KLFAMO/current3Av2/README.md

# current3Av2
Current driver for compensating coils
