KLFAMO/current3Av2/kicad/current3Av2_bom.ods

Source: | D:\Projekty\FAMO\current3Av2\current3Av2.sch
Date: | 03.01.2023 12:33:08
Tool: | Eeschema (5.1.12)-1
Generator: | C:\Program Files\KiCad\bin\scripting\plugins/bom_csv_grouped_by_value.py
Component Count: | 218
Item | Qty | Reference(s) | Value | Footprint | Datasheet | Comm | Vendor
1 | 30 | C5, C8, C12, C18, C21, C24, C26, C31, C32, C38, C42, C46, C51, C52, C58, C62, C65, C67, C68, C69, C72, C74, C75, C78, C83, C85, C91, C92, C93, C95 | 100n 50V X7R | Capacitors_SMD:C_0603 | ~
2 | 9 | C13, C33, C53, C73, C76, C81, C82, C86, C89 | 100p 50V C0G | Capacitors_SMD:C_0603 | ~
3 | 19 | C2, C3, C7, C10, C11, C14, C17, C22, C23, C28, C34, C36, C45, C54, C56, C63, C71, C90, C94 | 10u 25V X5R | Capacitors_SMD:C_0603 | ~ | GRM188R61E106KA73D
4 | 4 | C1, C15, C35, C55 | 1n 50V C0G | Capacitors_SMD:C_0603 | ~
5 | 2 | C57, C59 | 1u 25V X7R | Capacitors_SMD:C_0603 | ~
6 | 3 | C47, C49, C96 | 470n 25V X7R | Capacitors_SMD:C_0603 | ~
7 | 1 | C27 | 56p 50V C0G | Capacitors_SMD:C_0603 | ~
8 | 1 | C60 | 82p 50V C0G | Capacitors_SMD:C_0603 | ~
9 | 3 | C84, C87, C88 | DNP | Capacitors_SMD:C_0603 | ~
10 | 1 | C44 | 10n 100V X7R | Capacitors_SMD:C_0805 | ~
11 | 2 | C43, C50 | 2,2u 25V X7R | Capacitors_SMD:C_0805 | ~
12 | 2 | C6, C16 | 470n 100V X7R | Capacitors_SMD:C_0805 | ~
13 | 3 | C37, C39, C40 | 100n 50V C0G | Capacitors_SMD:C_1206 | ~
14 | 4 | C66, C70, C79, C80 | GRM31CR71A226KE15L | Capacitors_SMD:C_1206 | ~ | 22u 10V X7R Murata
15 | 2 | C29, C41 | GRM32ER71E226KE15K | Capacitors_SMD:C_1210 | ~ | 22u 25V X7R Murata
16 | 3 | C20, C30, C61 | GRM32ER71H106KA12L | Capacitors_SMD:C_1210 | ~ | 10u 50V X7R Murata
17 | 2 | C19, C64 | 100u 16V | Capacitors_Tantalum_SMD:CP_Tantalum_Case-D_EIA-7343-31_Reflow | ~ | tantal, case D
18 | 4 | C4, C9, C25, C48 | 2200u 16V 105°C | Capacitors_THT:CP_Radial_D14.0mm_P5.00mm | ~ | >5000h Ø13x25mm P=5mm
19 | 2 | JF1, JF2 | Amphenol 031-6575 | Connector_Coaxial:BNC_Amphenol_031-6575_Horizontal | ~ | 031-6576
20 | 1 | SD1 | DM3D-SF | Connectors_Card:Hirose_DM3D-SF | https://www.hirose.com/product/document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
21 | 2 | J6, J7 | ZL231-10PG | Connectors_IDC:IDC-Header_2x05_Pitch2.54mm_Straight | ~ |  | Connfly
22 | 4 | J1, J2, J3, J4 | MSTBA 2,5/ 2-G-5,08 1757242 | Connectors_Phoenix:PhoenixContact_MSTBA-G_02x5.08mm_Angled | ~ |  | Adam Tech, TE Connectivity, Xinya, Ninigi
23 | 1 | D28 | SMAJ16A | Diodes_SMD:D_SMA | ~
24 | 15 | D2, D3, D4, D7, D8, D11, D20, D24, D25, D26, D30, D35, D36, D37, D38 | SL54-3G | Diodes_SMD:D_SMB | ~ | Diotec SL54-3G
25 | 3 | D5, D6, D9 | BZT52C18 | Diodes_SMD:D_SOD-123 | ~
26 | 1 | PD7 | LAM 5K 150 12V, dodać: THFU4 – 3szt., wkręt do metalu – 3 szt (Φmax 3mm), podkładki płaskie i sprężyste !!! | ff_lib:Heatsink_50x50x150mm_with_fan_C | https://www.fischerelektronik.de/web_fischer/en_GB/VA/LAM3K10012/datasheet.xhtml?branch=heatsinks | dodać: THFU4 – 3szt., wkręt do metalu – 3 szt (Φmax 3mm)
27 | 1 | L8 | SRP3212-3R3M | ff_lib:L_Bourns_SRP3212 | ~ | 3,3u >2A 4x4mm
28 | 1 | L1 | 50225C Murata | ff_lib:L_CommonMode_Murata_5000 | https://www.murata-ps.com/pub/data/magnetics/kmp_5000c.pdf | or 50475C
29 | 3 | L2, L5, L7 | LQH44PH220MPRL | ff_lib:L_MURATA_LQH44 | ~ | 22u >0,5A 4x4mm
30 | 1 | M1 | po1:DS1023-2*8S21, DS1023-2*10S21, DS1023-2*16S21, DS1023-2*17S21 | ff_lib:MODULE_NUCLEO-F746ZG_mini_M | STMicroelectronics
31 | 1 | U33 | R1SE-H2 | ff_lib:SOIC-5_8-10.7x12.75_Pitch2.54 | https://recom-power.com/pdf/Econoline/R1SE_H2.pdf | ISE1205A, SBTN01M-05, AM1LS-1205S-NZ
32 | 3 | U9, U18, U27 | OPA549 dowolna wersja | ff_lib:TO-220-11_Vertical_StangeredType1_or_not | http://www.ti.com/lit/ds/symlink/opa549.pdf
33 | 1 | U29 | ADUM141D1BRWZ | Housings_SOIC:SOIC-16W_7.5x10.3mm_Pitch1.27mm | https://www.analog.com/media/en/technical-documentation/data-sheets/ADUM1410_1411_1412.pdf | ADUM141D1BRWZ-RL, ADUM241D1BRIZ
34 | 6 | U2, U3, U4, U5, U7, U8 | IRS4428SPBF | Housings_SOIC:SOIC-8_3.9x4.9mm_Pitch1.27mm | https://www.ixysic.com/home/pdfs.nsf/www/IX4426-27-28.pdf/$file/IX4426-27-28.pdf | IX4428N
35 | 1 | U11 | MAX3250CAI | Housings_SSOP:SSOP-28_5.3x10.2mm_Pitch0.65mm | https://datasheets.maximintegrated.com/en/ds/MAX3250.pdf | MAX3250EAI+
36 | 1 | U14 | DAC8555IPW | Housings_SSOP:TSSOP-16_4.4x5mm_Pitch0.65mm | http://www.ti.com/lit/gpn/dac8555
37 | 1 | L4 | 33uH 200mA | Inductors_SMD:L_0805 | ~ | Viking NL05JTC330
38 | 2 | L3, L6 | 74477710 | Inductors_SMD:L_Wuerth_HCM-7050 | ~ | 10u >2A 7x7mm
39 | 1 | U12 | ADR443BRZ | Package_SO:SOIC-8_3.9x4.9mm_P1.27mm | https://www.analog.com/media/en/technical-documentation/data-sheets/ADR440_441_443_444_445.pdf
40 | 3 | D1, D10, D19 | 2BZX84C15 | Package_TO_SOT_SMD:SOT-23 | ~
41 | 3 | U6, U15, U24 | INA293B2IDBV | Package_TO_SOT_SMD:SOT-23-5 | https://www.ti.com/lit/ds/symlink/ina293.pdf?ts=1623847588072
42 | 12 | T1, T2, T3, T4, T5, T6, T7, T8, T9, T10, T11, T12 | BSC028N06NSATMA1 ** | Package_TO_SOT_SMD:TDSON-8-1 | http://www.infineon.com/dgdl/Infineon-BSC028N06LS3-DS-v02_02-en.pdf?fileId=db3a30431ddc9372011ebafa4c607f8c
43 | 2 | U1, U10 | AP63200WU | Package_TO_SOT_SMD:TSOT-23-6 | https://www.diodes.com/assets/Datasheets/AP63200-AP63201-AP63203-AP63205.pdf | AP63201WU
44 | 1 | U13 | AP63203WU-7 | Package_TO_SOT_SMD:TSOT-23-6 | https://www.diodes.com/assets/Datasheets/AP63200-AP63201-AP63203-AP63205.pdf
45 | 6 | R3, R4, R16, R17, R28, R29 | 10k 1% | Resistors_SMD:R_0603 | ~
46 | 6 | R7, R8, R19, R20, R31, R32 | 10R | Resistors_SMD:R_0603 | ~
47 | 3 | R11, R23, R35 | 14k 1% | Resistors_SMD:R_0603 | ~
48 | 1 | R44 | 180k 1% | Resistors_SMD:R_0603 | ~
49 | 18 | R1, R2, R5, R6, R9, R10, R13, R14, R15, R18, R21, R22, R25, R26, R27, R30, R33, R51 | 1k 1% | Resistors_SMD:R_0603 | ~
50 | 2 | R38, R45 | 20k 1% | Resistors_SMD:R_0603 | ~
51 | 1 | R37 | 280k 1% | Resistors_SMD:R_0603 | ~
52 | 3 | R39, R40, R41 | 47R | Resistors_SMD:R_0805 | ~
53 | 3 | R34, R42, R43 | DNP | Resistors_SMD:R_0805 | ~
54 | 3 | R12, R24, R36 | 0R02 0,5% 1W 50ppm | Resistors_SMD:R_2512 | ~ | LVK24R020DER
55 | 1 | RN1 | CAT16-101J4LF | Resistors_SMD:R_Array_Concave_4x0603 | ~
56 | 1 | RN3 | CAT16-472J4LF | Resistors_SMD:R_Array_Concave_4x0603
57 | 1 | FAN1 | TE 1546551-3 | TerminalBlock_4UCON:TerminalBlock_4UCON_19963_03x3.5mm_Straight | ~
58 | 1 | U31 | UA78M05IDCY | TO_SOT_Packages_SMD:SOT-223-3_TabPin2
** T1-T12: IAUC100N04S6L025ATMA1, BSC014N04LSATMA1, BSC019N04LSATMA1, BSC014N04LSIATMA1, BSC014N04LSTATMA1, BSC010N04LSATMA1, BSC027N04LSGATMA1, IQE013N04LM6ATMA1, CSD18509Q5BT, CSD18502Q5BT, MCAC95N06Y-TP, MCAC95N065Y-TP, CSD18512Q5B, TSM025NH04LCR RLG, TSM019NH04LCR RLG, BSC010N04LS6ATMA1, ISC012N04LM6ATMA1
