KLFAMO/current3Av2/kicad/current3Av2.pdf

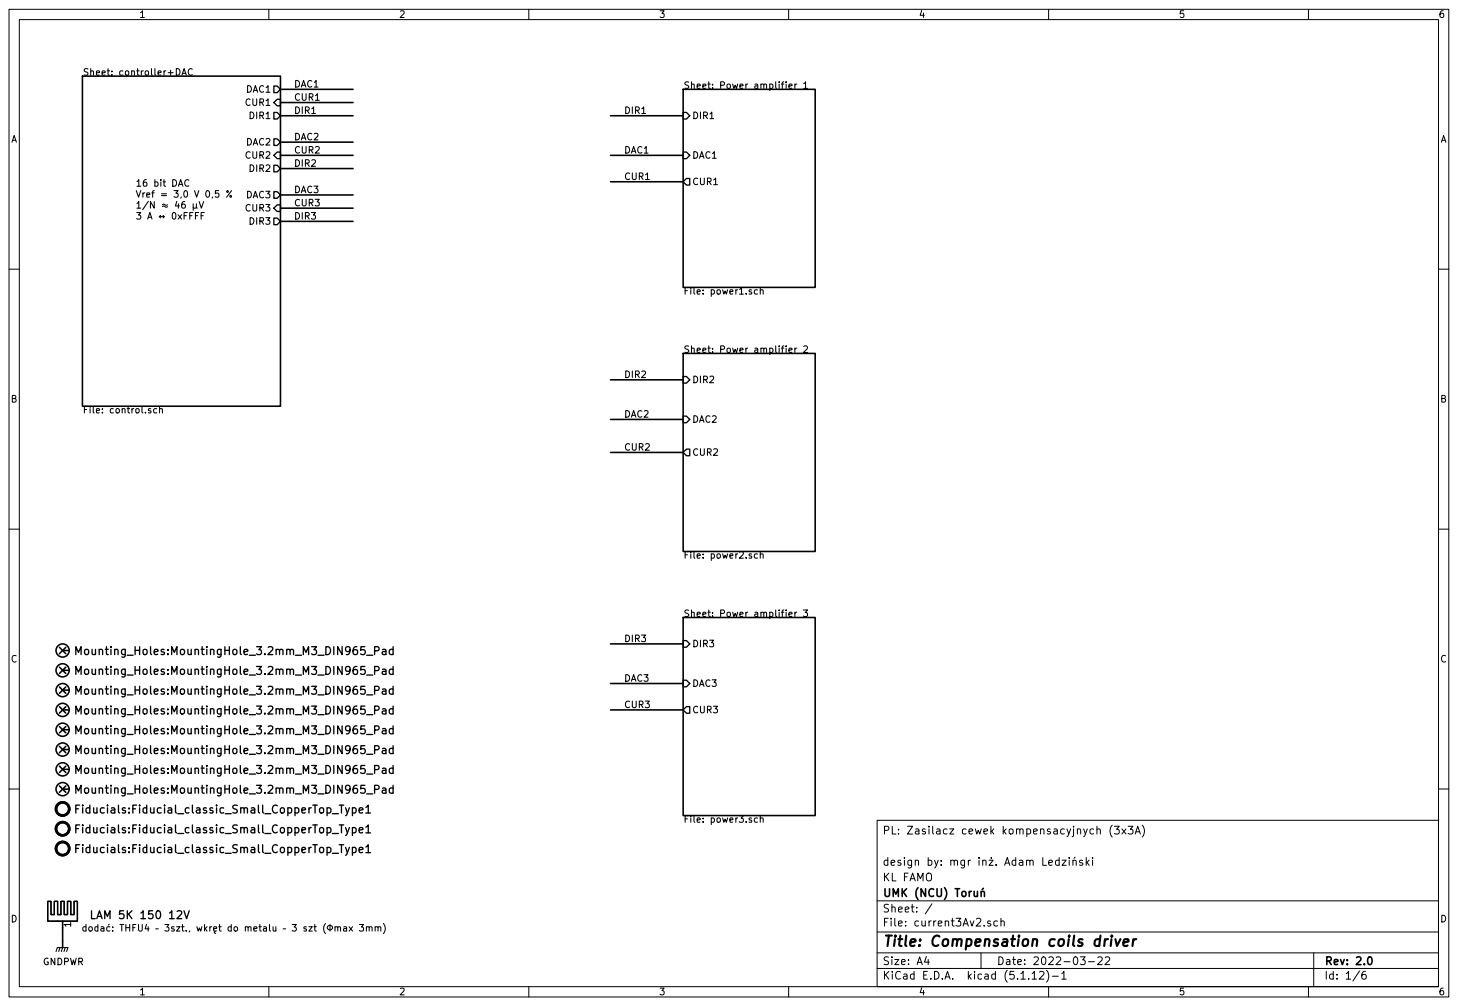
[picture p1: page 1]

Sheet: Power amplifier 1
File: power1.sch DAC1 CUR1 DIR1 Sheet: Power amplifier 2

File: power2.sch DAC2 CUR2 DIR2 Sheet: Power amplifier 3

PL: Zasilacz cewek kompensacyjnych (3x3A)

design by: mgr in. Adam Ledziski
Id: 1/6 Title: Compensation coils driver File: current3Av2.sch Sheet: / UMK (NCU) Toru KL FAMO

doda: THFU4 3szt., wkrt do metalu 3 szt (max 3mm)

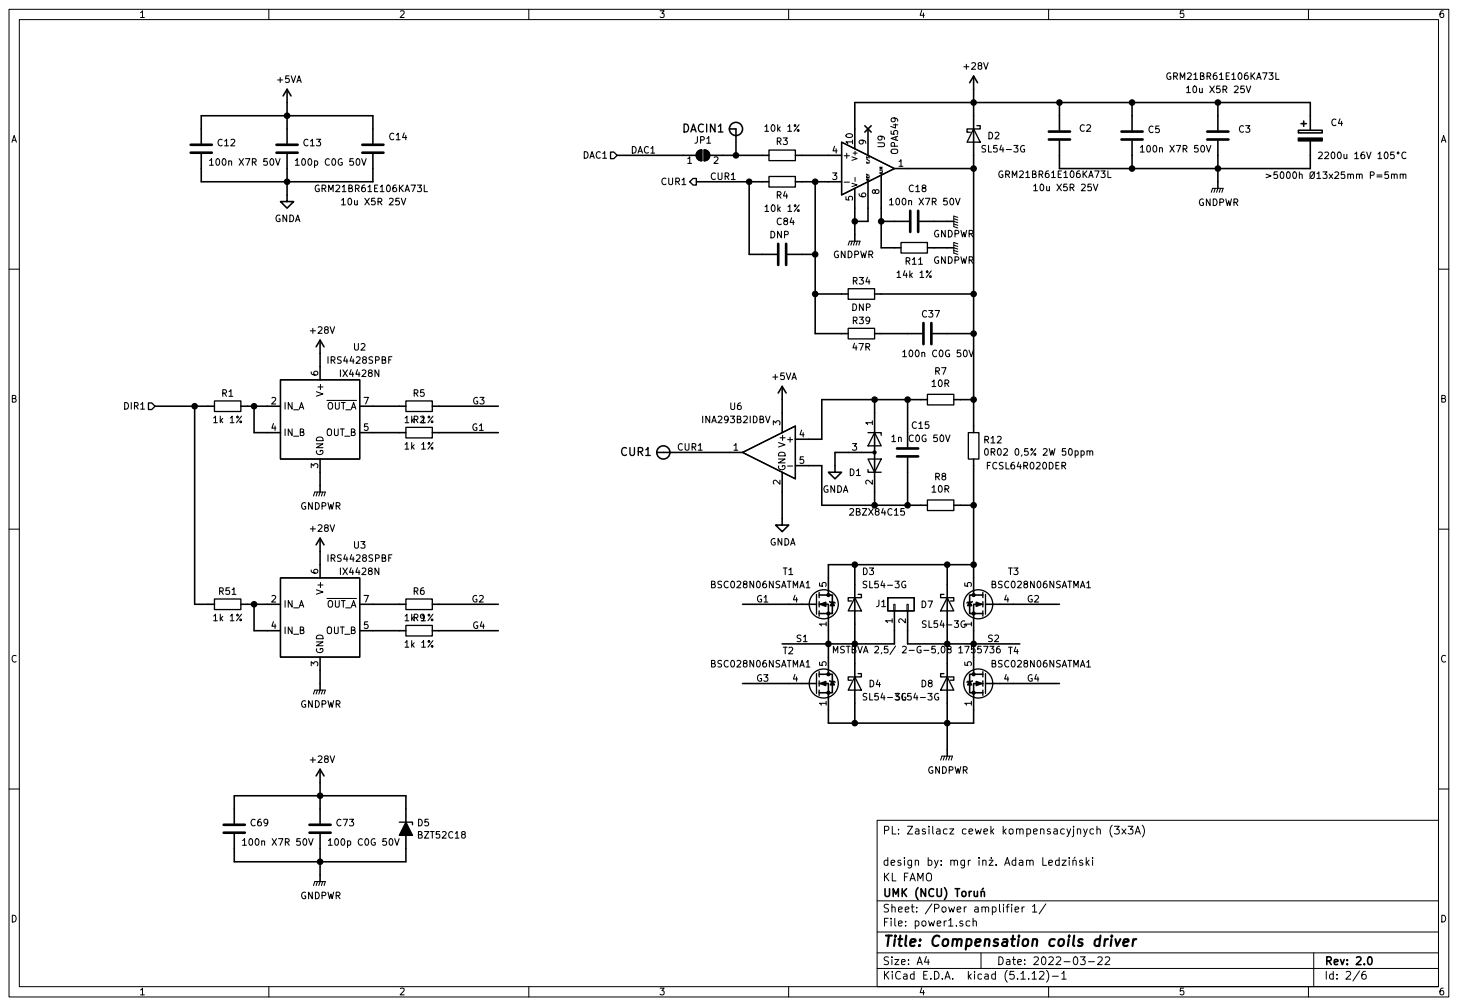
[picture p2: page 2]

PL: Zasilacz cewek kompensacyjnych (3x3A)

design by: mgr in. Adam Ledziski
UMK (NCU) Toru KL FAMO

Sheet: /Power amplifier 1/
File: power1.sch
Id: 2/6 Title: Compensation coils driver

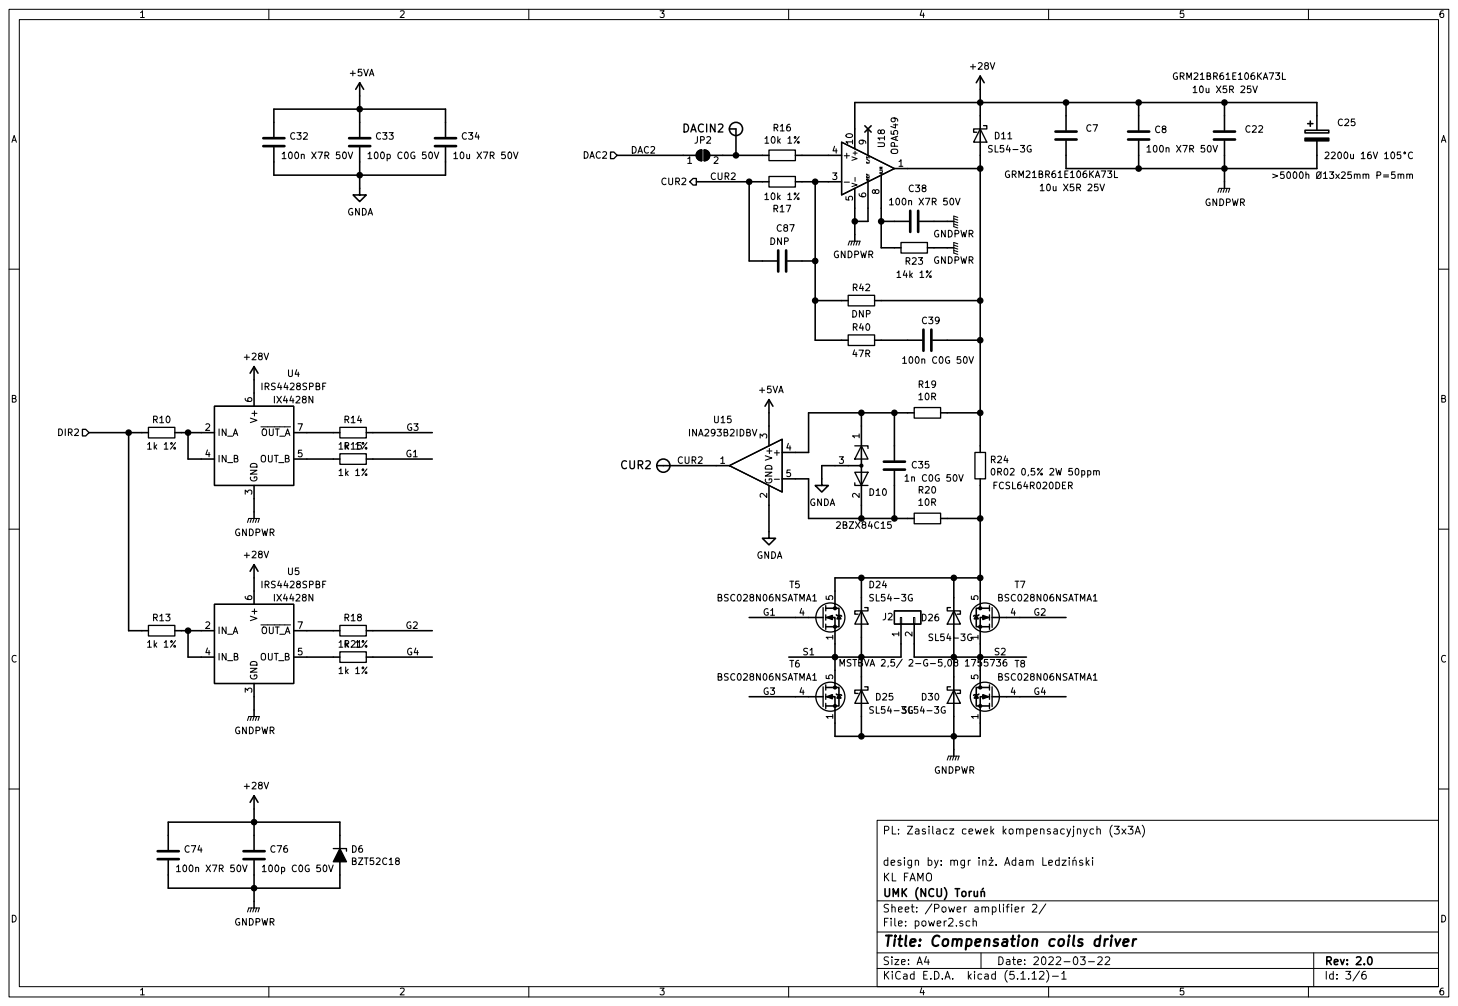
[picture p3: page 3]

PL: Zasilacz cewek kompensacyjnych (3x3A) D26SL54-3G

design by: mgr in. Adam Ledziski
UMK (NCU) Toru KL FAMO

Sheet: /Power amplifier 2/
File: power2.sch
Id: 3/6 Title: Compensation coils driver

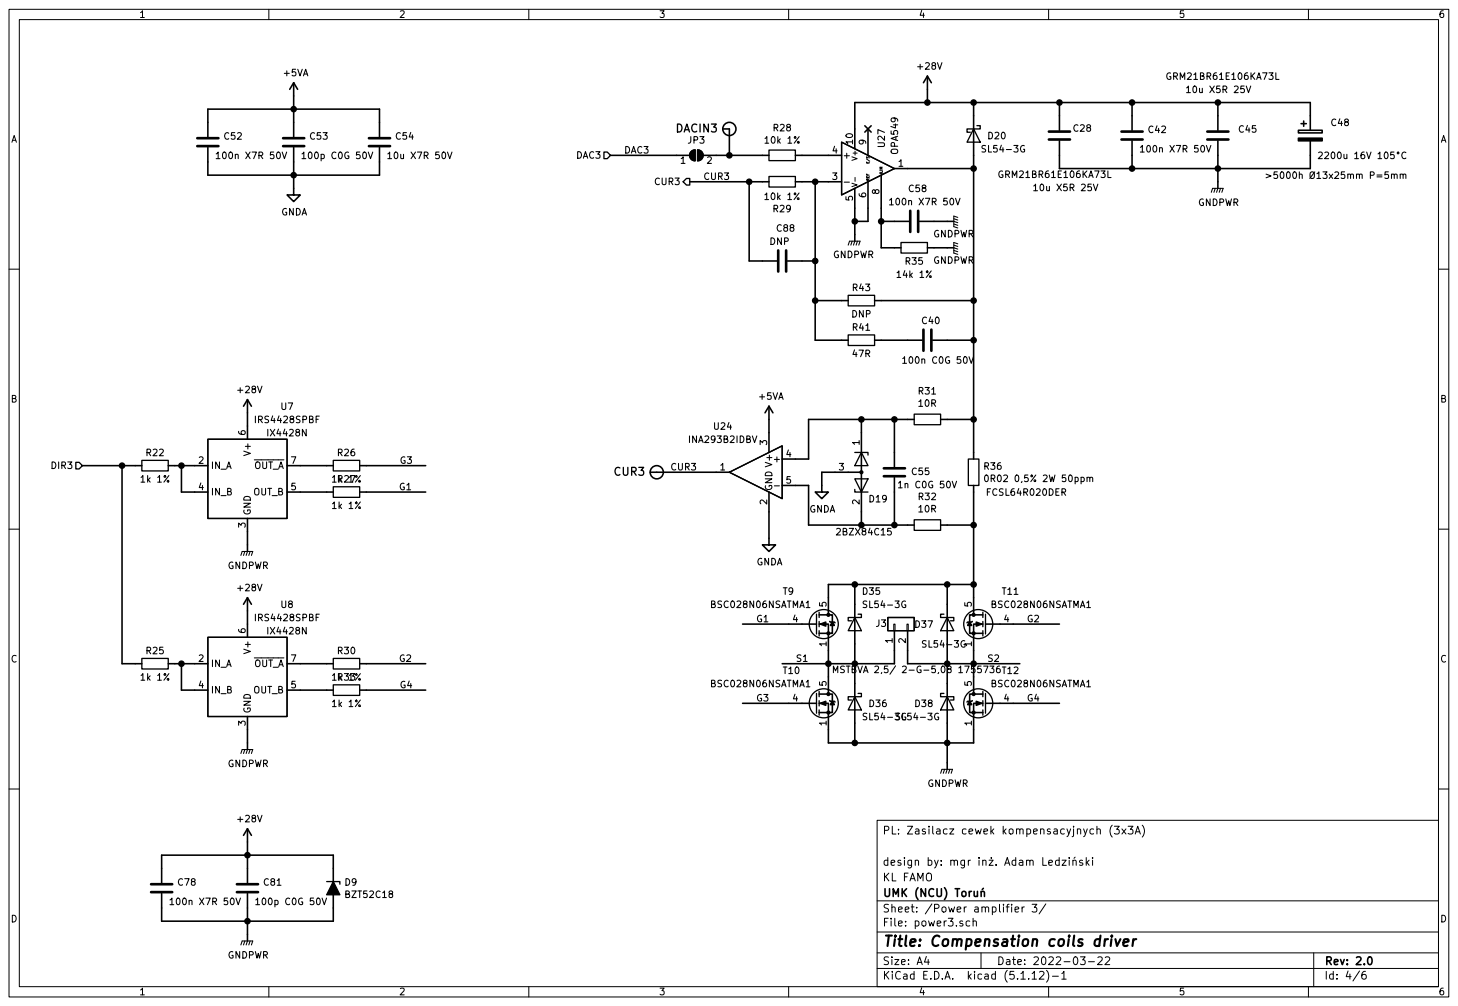
[picture p4: page 4]

PL: Zasilacz cewek kompensacyjnych (3x3A)

design by: mgr in. Adam Ledziski
UMK (NCU) Toru KL FAMO

Sheet: /Power amplifier 3/
File: power3.sch
Id: 4/6 Title: Compensation coils driver

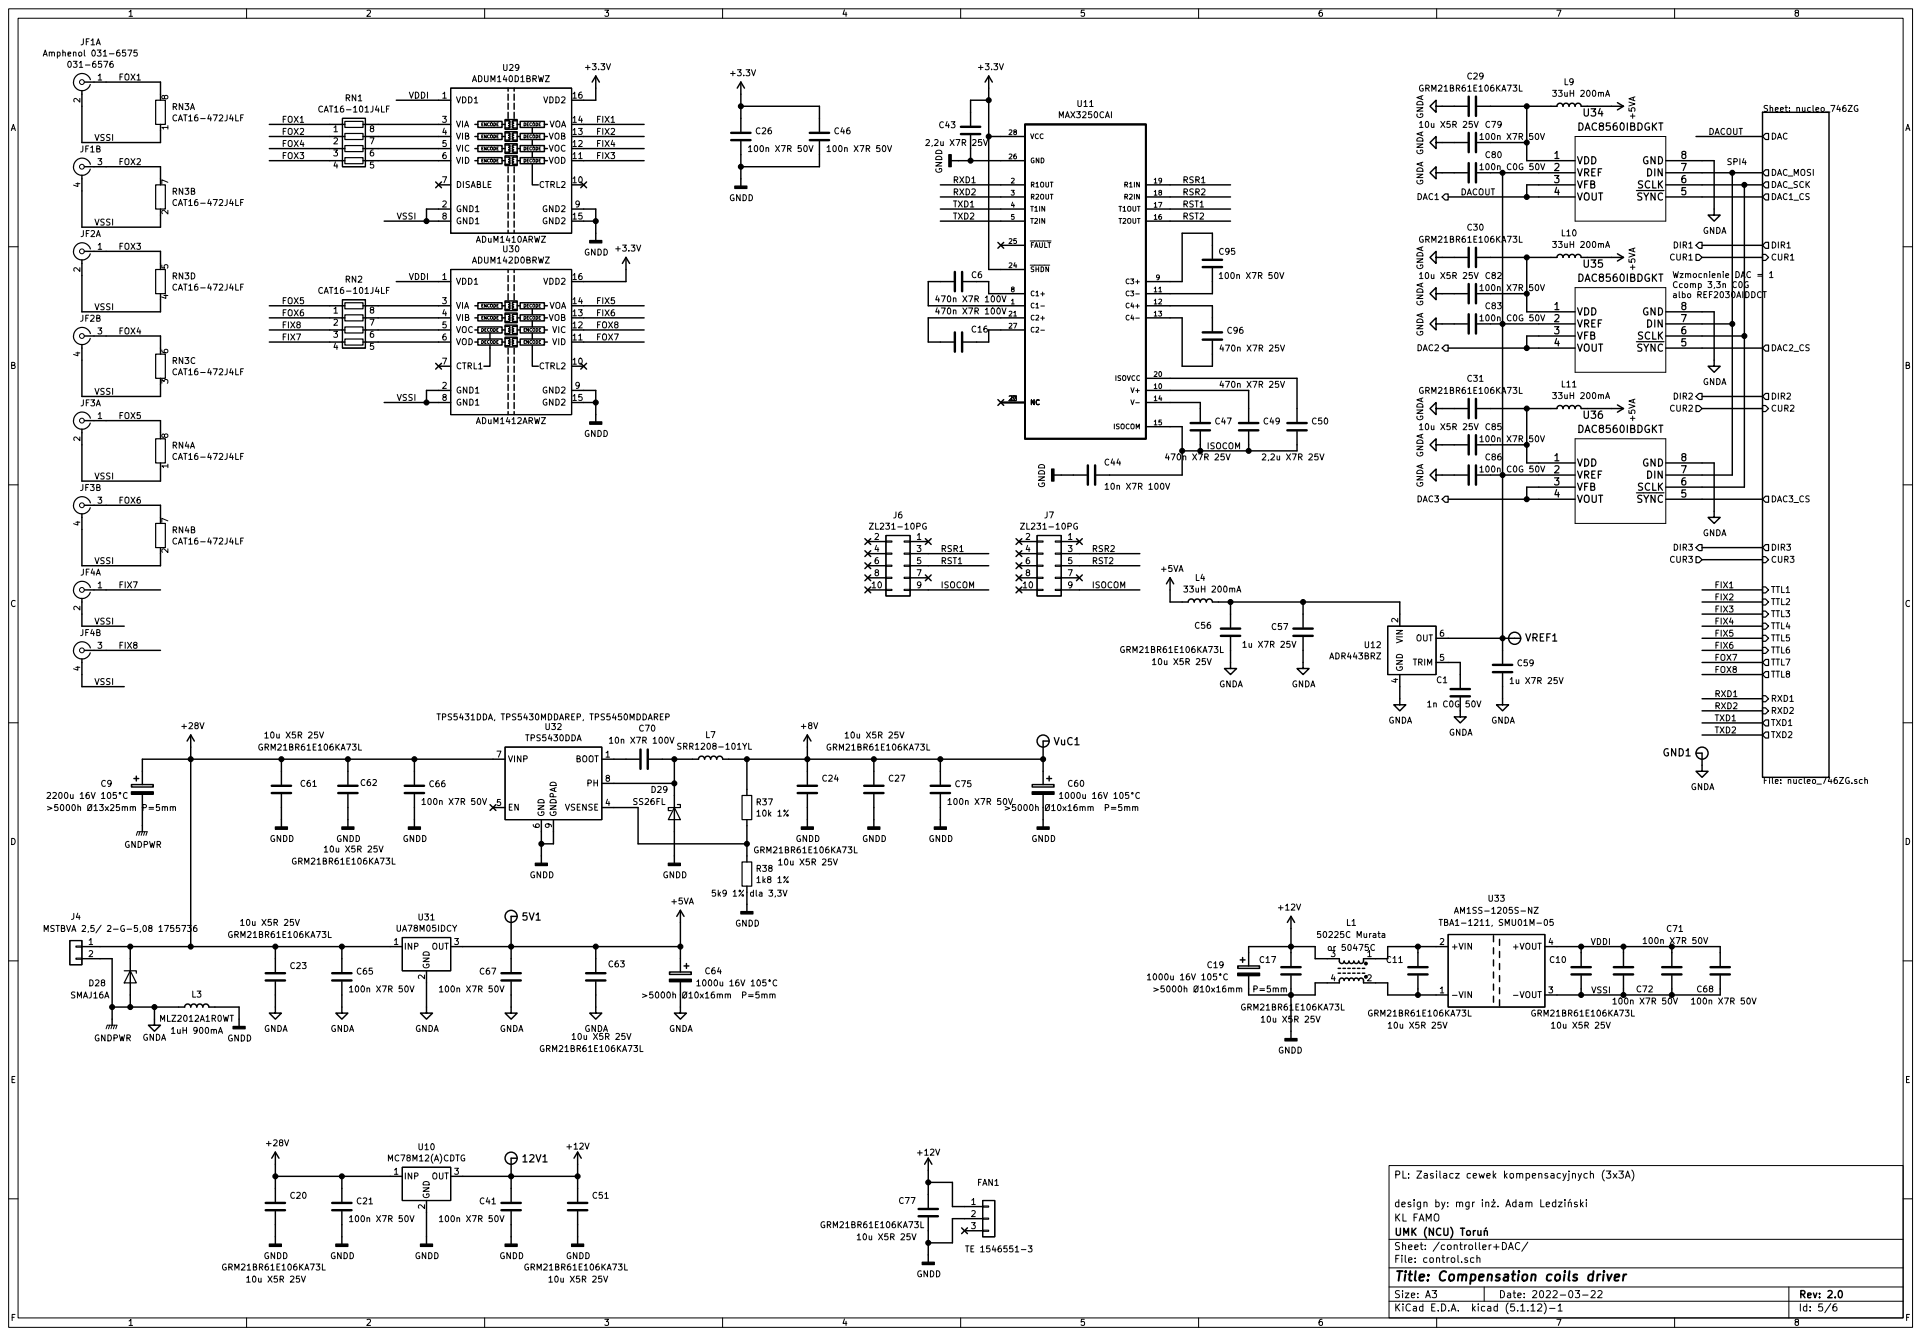
[picture p5: page 5]

DECODE DECODE

6 DIN
5 SCLK

4 TRIM 5 OUT 6 U12 ADR443BRZ GNDA GNDD GNDA GNDA GNDA C57

PL: Zasilacz cewek kompensacyjnych (3x3A)

design by: mgr in. Adam Ledziski
Id: 5/6 Title: Compensation coils driver File: control.sch Sheet: /controller+DAC/ UMK (NCU) Toru KL FAMO

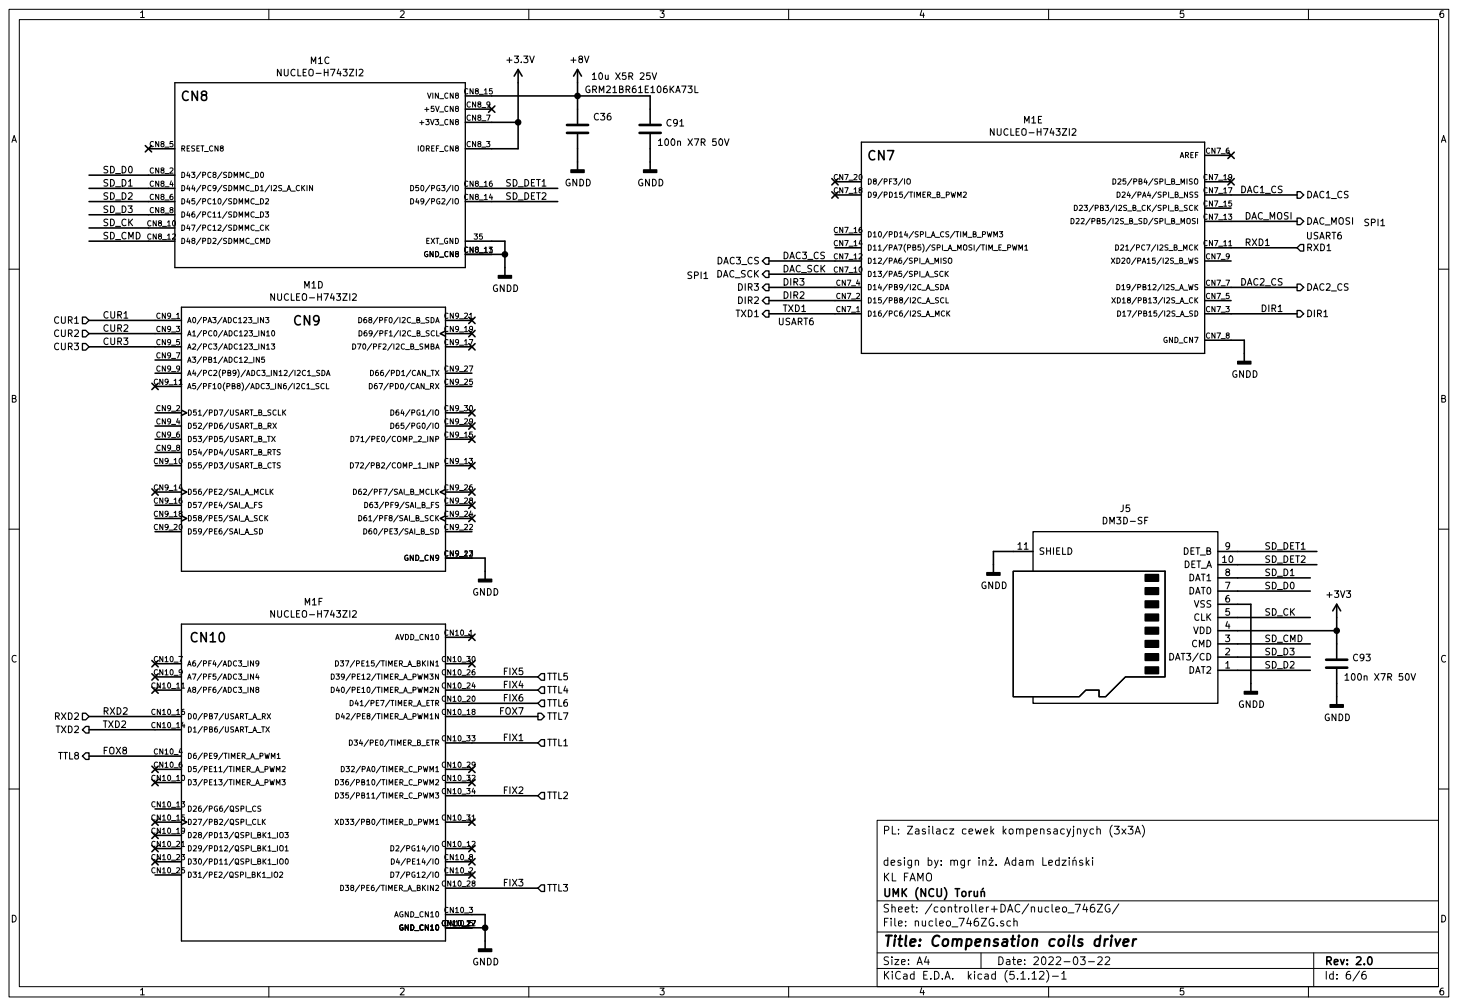
[picture p6: page 6]

PL: Zasilacz cewek kompensacyjnych (3x3A)

design by: mgr in. Adam Ledziski
UMK (NCU) Toru KL FAMO

Sheet: /controller+DAC/nucleo_746ZG/
File: nucleo_746ZG.sch
Id: 6/6 Title: Compensation coils driver
