KLFAMO/current3Av2/kicad/fabr/current3Av2-B_Fab.pdf

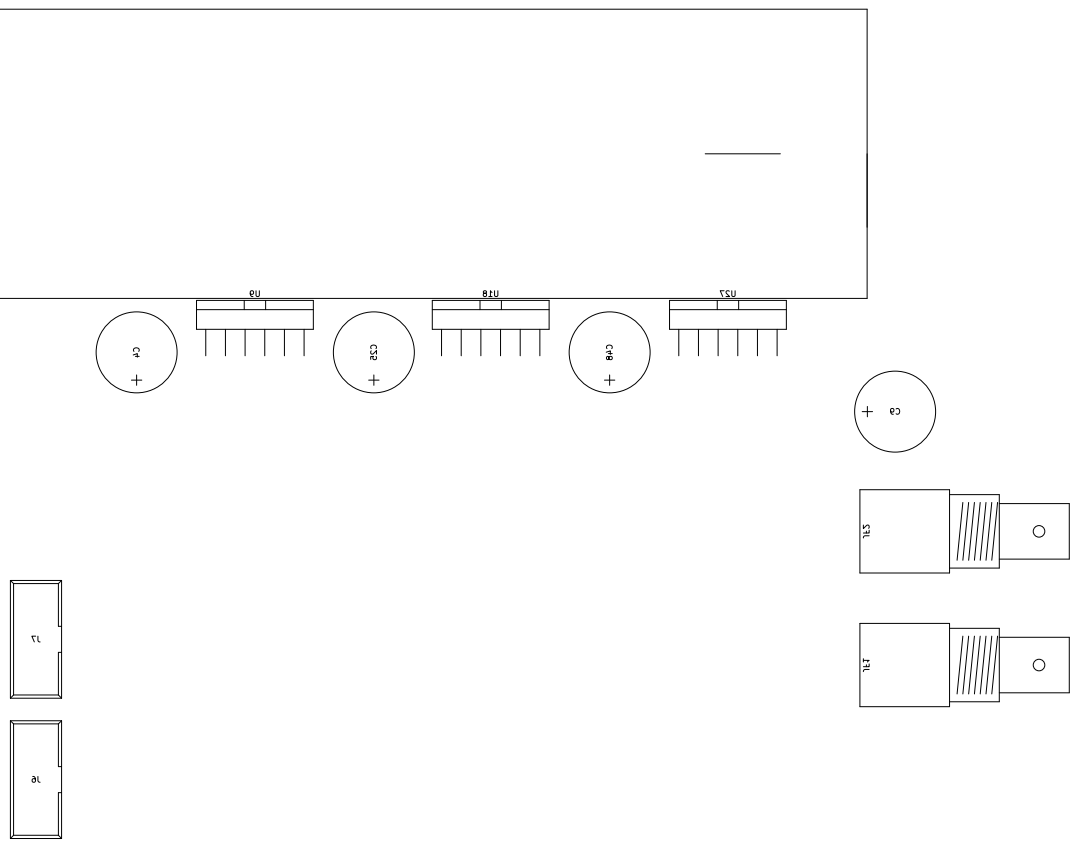
[picture p7: page 1]
