KLFAMO/current3Av2/kicad/fabr/current3Av2-Dwgs_User.pdf

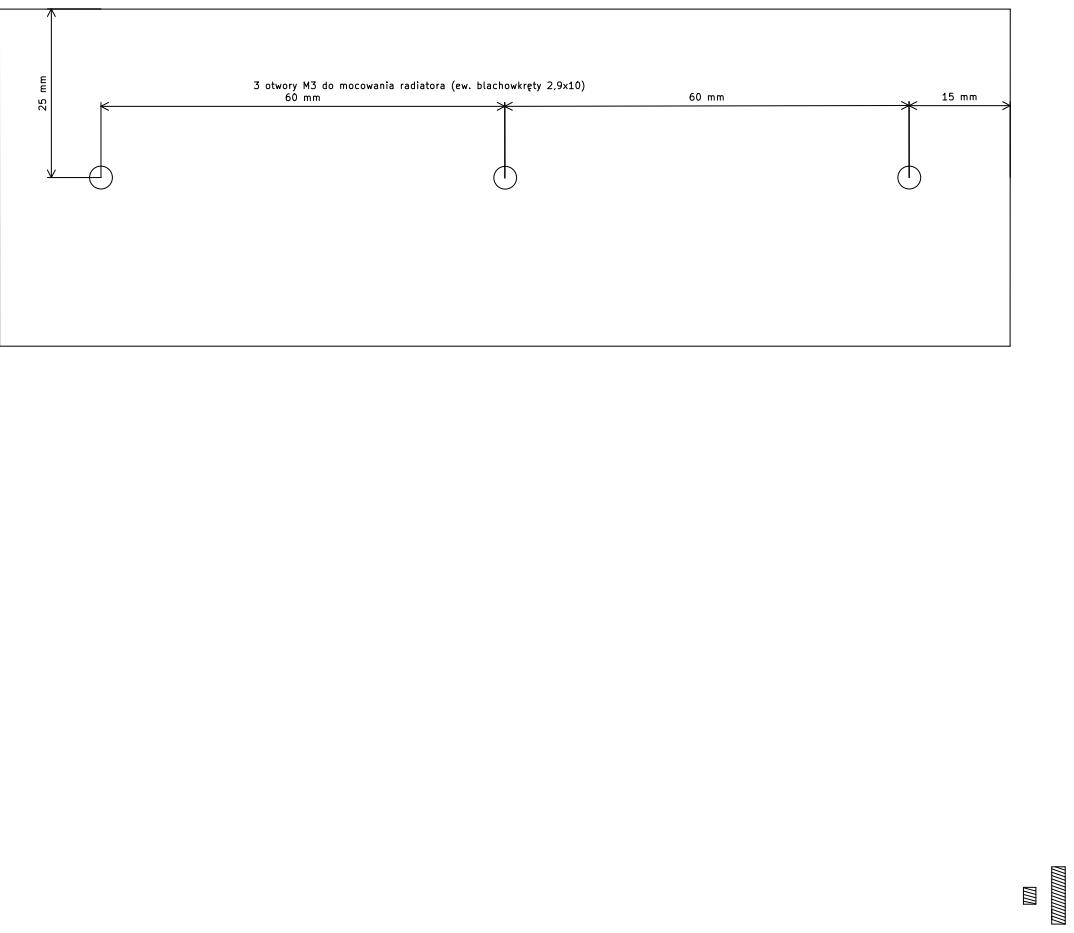
[picture p8: page 1]
