KLFAMO/current3Av2/kicad/fabr/current3Av2-F_Fab.pdf

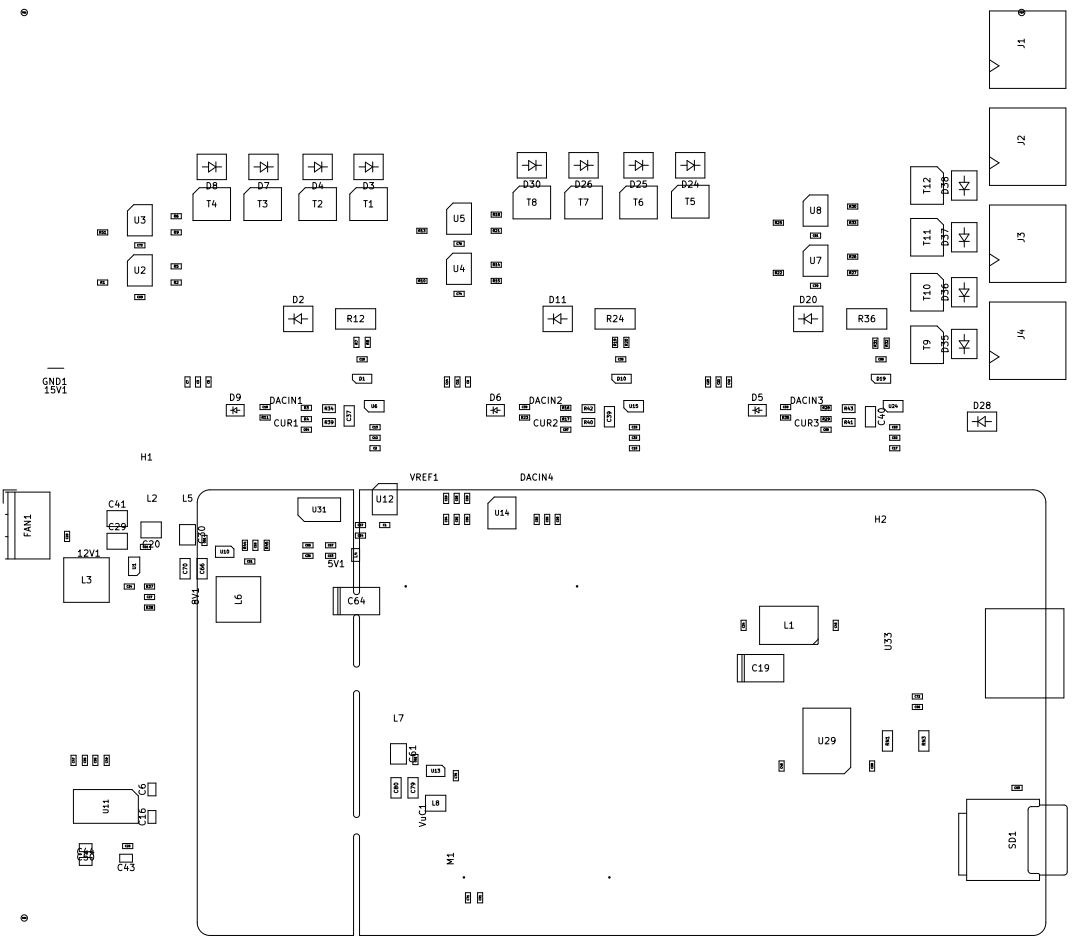
[picture p9: page 1]
