KLFAMO/current3Av2/kicad/symulacje/current_amp_full2.asc

C1: cap; 1e-9; V=50
C2: cap; 10e-9
C3: cap; 3.3e-9
L1: ind; 47e-6; Rser=5
R1: res; 20e-3; tol=1
R2: res; 10
R3: res; 10
R4: res; 20e3; tol=1
R5: res; 10e3; tol=1
R6: res; 20e3; tol=1
R7: res; 2e3; tol=1
R8: res; 10e3; tol=1
R9: res; 10e3; tol=1
R10: res; 20e3; tol=1
U1: LT1210
U2: AD8205
U4: ADA4622
V1: voltage; 30
V2: voltage; 15
V3: voltage; PULSE(0 3.3 0 0.005 0.005 0.015 0.04); AC 1
V4: voltage; SINE(1.65 1.65 25 0 0 0); AC 1
V5: voltage; 5
Named nets: 0
.tran 0 .5 .4 0.0001
