KLFAMO/current3Av2/kicad/symulacje/current_amp_full_light.asc

C3: cap; 3.3e-9
L1: ind; 47e-6; Rser=5
R1: res; 1
R4: res; 20e3; tol=1
R5: res; 10e3; tol=1
R6: res; 20e3; tol=1
R7: res; 1000; tol=1
R9: res; 10e3; tol=1
R10: res; 20e3; tol=1
U1: LT1210
U4: ADA4622
V1: voltage; 30
V2: voltage; 15
V4: voltage; SINE(1.65 1.65 25 0 0 0); AC 1
V5: voltage; 7
Named nets: 0
.tran 0 .5 .4 0.0001
