KLFAMO/current3Av2/kicad/symulacje/current_amp_light.asc

L1: ind; 47e-6; Rser=5
R1: res; 1
R4: res; 500; tol=1
R9: res; 1000; tol=1
U1: LT1739
V1: voltage; 15
V4: voltage; SINE(.5 .5 25 0 0 0); AC 1
V5: voltage; 15
Named nets: 0
.tran 0 .5 .4 0.0001
