KLFAMO/current3Av2/kicad/symulacje/current_amp_u.asc

C1: cap; 1e-9; V=50
L1: ind; 47e-3; Rser=1
R1: res; 1; tol=1
R2: res; 1e4; tol=1
R3: res; 1e4; tol=1
R4: res; 1e4; tol=1
R5: res; 1e4; tol=1
U1: LT1210
V1: voltage; 30
V3: voltage; SINE(1 0.5 25); AC 1
Named nets: 0
.tran 0 .5 .4 0.0001
