KLFAMO/current3Av2/kicad/current3Av2.kicad_pcb

## KiCad design kicad/current3Av2.kicad_pcb (2024-01-12)

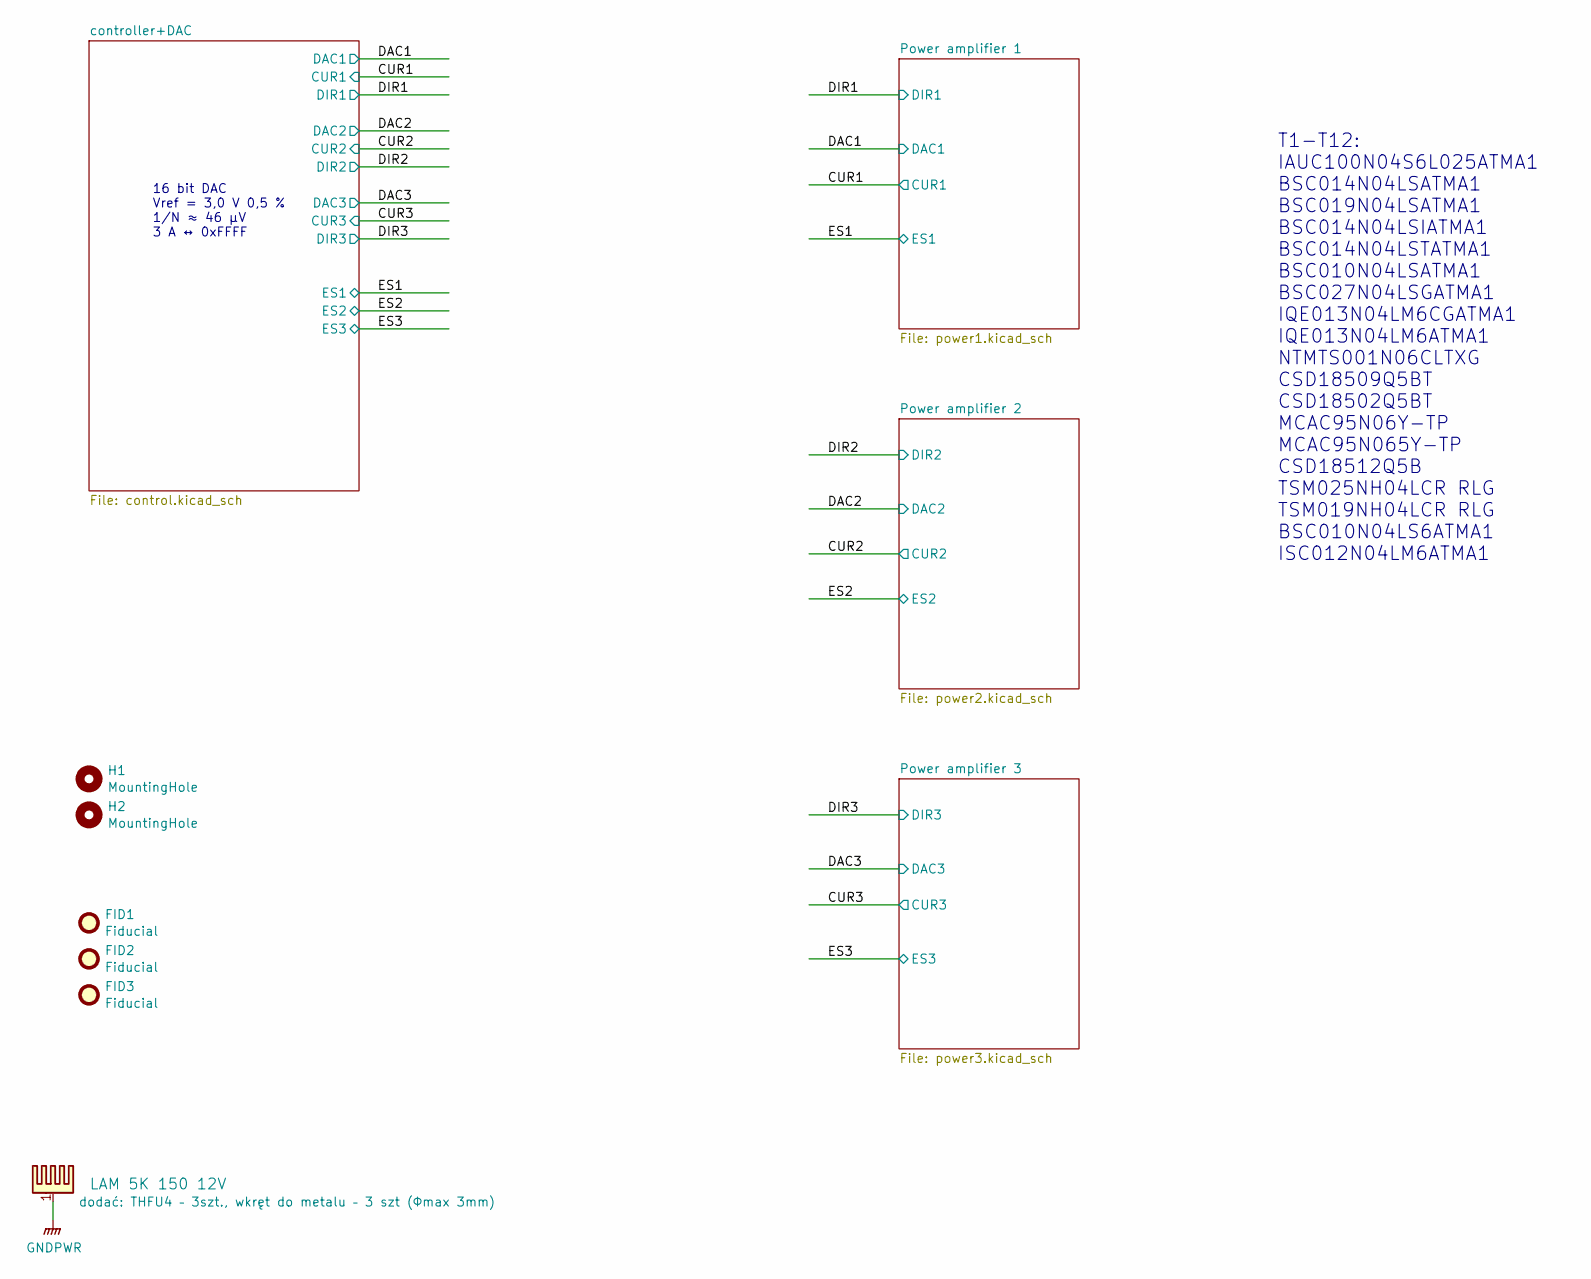
[picture p10: schematic current3Av2.kicad_sch, Compensation coils driver]

Parts:
FID1, FID2, FID3: Fiducial; Fiducial_0.5mm_Dia_1mm_Outer
H1, H2: MountingHole; MountingHole_3.2mm_M3_Pad_Via
PD7: LAM 5K 150 12V; Heatsink_50x50x150mm_with_fan_C

Connections:
GND: PD7.1; also elsewhere on the board

Notes on the sheet:
16 bit DAC Vref = 3,0 V 0,5 % 1/N ≈ 46 µV 3 A ↔ 0xFFFF
T1-T12: IAUC100N04S6L025ATMA1 BSC014N04LSATMA1 BSC019N04LSATMA1 BSC014N04LSIATMA1 BSC014N04LSTATMA1 BSC010N04LSATMA1 BSC027N04LSGATMA1 IQE013N04LM6CGATMA1 IQE013N04LM6ATMA1 NTMTS001N06CLTXG CSD18509Q5BT CSD18502Q5BT MCAC95N06Y-TP MCAC95N065Y-TP CSD18512Q5B TSM025NH04LCR RLG TSM019NH04LCR RLG BSC010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

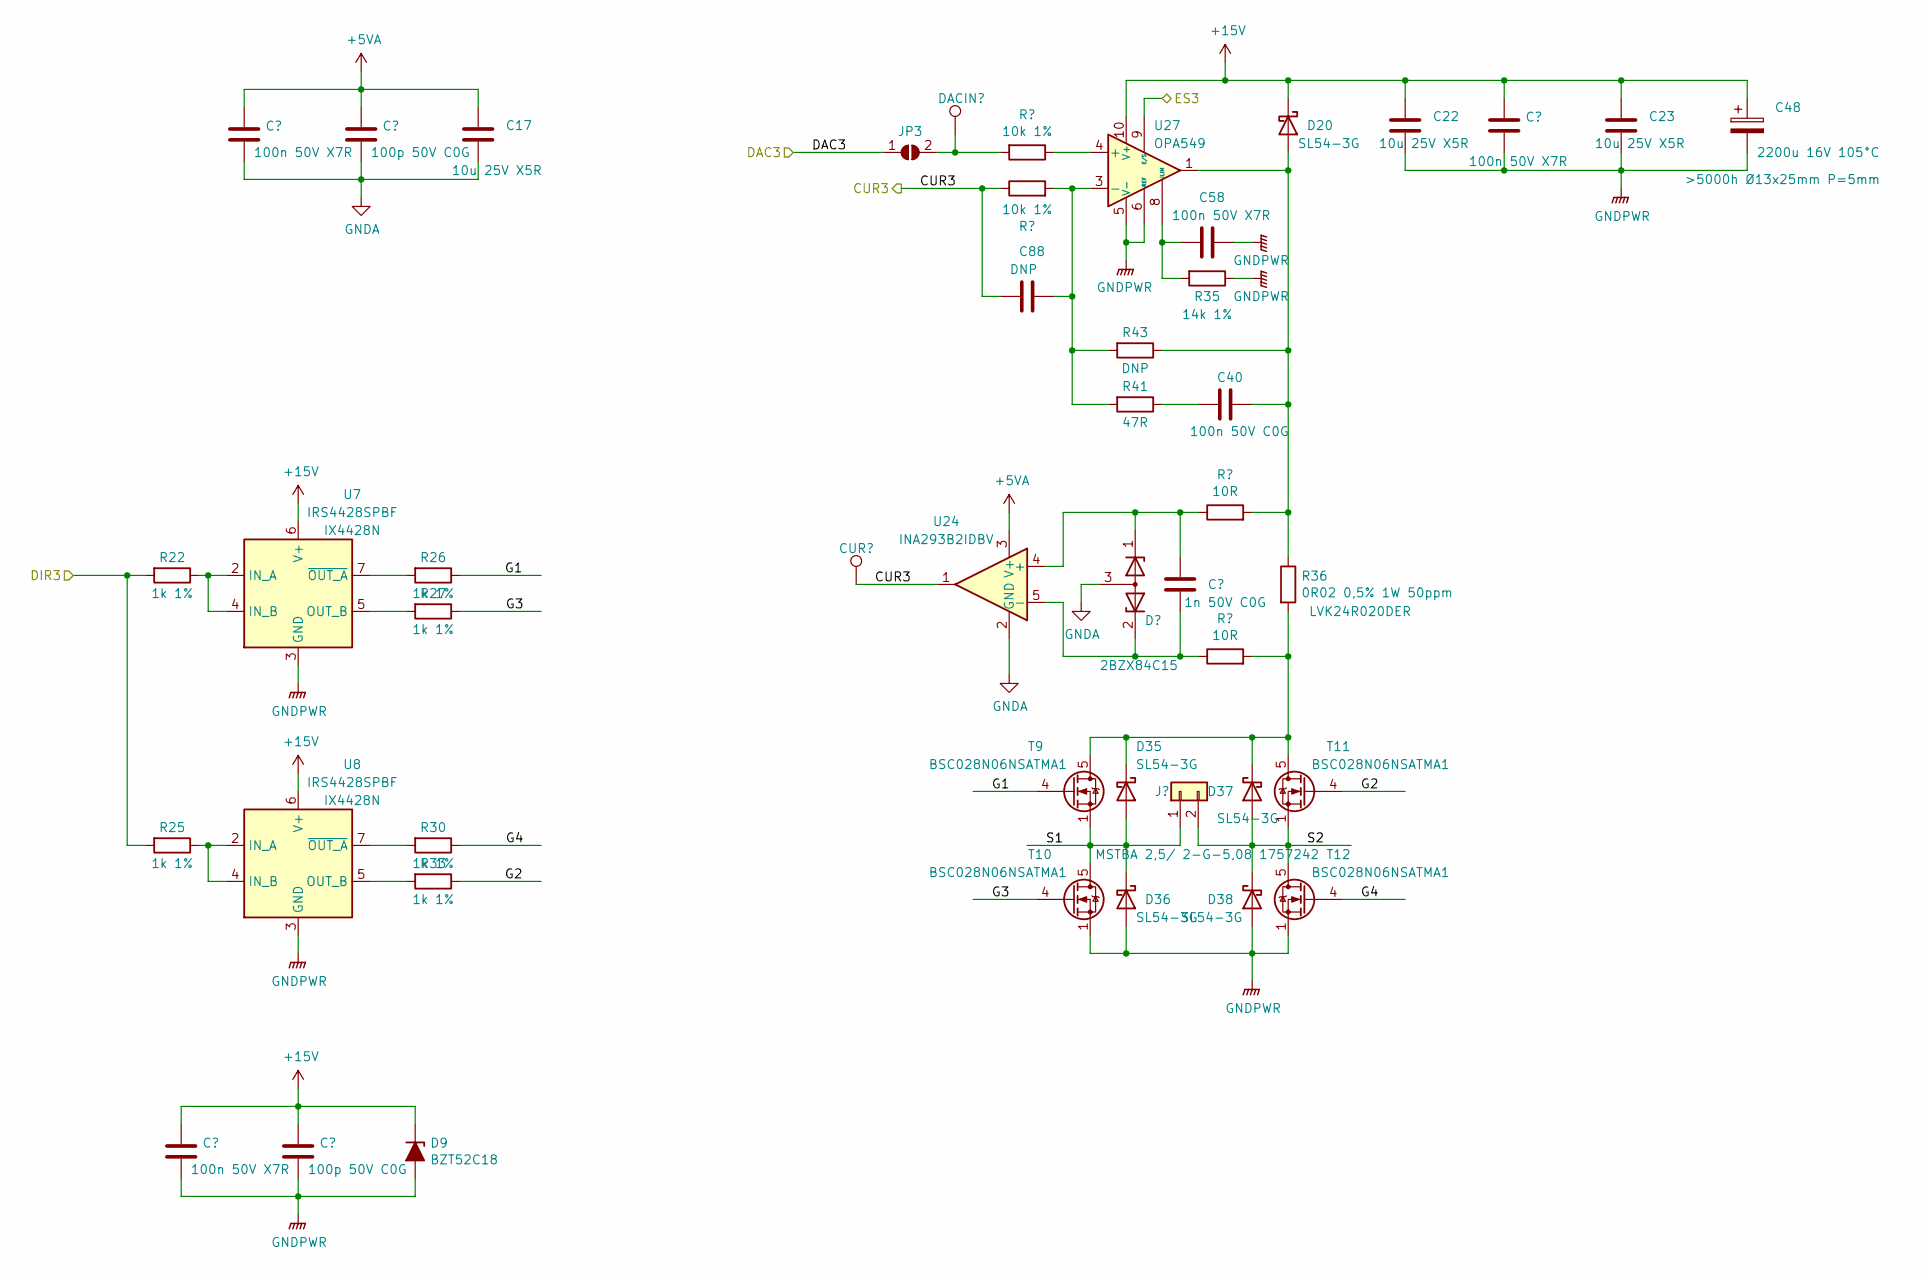
[picture p11: schematic power3.kicad_sch, Compensation coils driver]

Parts:
C17, C22, C23: 10u 25V X5R; C_0603
C40: 100n 50V C0G; C_1206
C42, C52, C58, C78: 100n 50V X7R; C_0603
C48: 2200u 16V 105°C; CP_Radial_D14.0mm_P5.00mm
C53, C81: 100p 50V C0G; C_0603
C55: 1n 50V C0G; C_0603
C88: DNP; C_0603
CUR3: TestPoint; Test_Point_THTPad_1.5x1.5mm_Drill0.7mm
D9: BZT52C18; D_SOD-123
D19: 2BZX84C15; SOT-23
D20, D35, D36, D37, D38: SL54-3G; D_SMB
DACIN3: TestPoint; Test_Point_THTPad_1.5x1.5mm_Drill0.7mm
J3: MSTBA 2,5/ 2-G-5,08 1757242; PhoenixContact_MSTBA-G_02x5.08mm_Angled
JP3: SolderJumper_2_Open; GS2_small
R22, R25, R26, R27, R30, R33: 1k 1%; R_0603
R28, R29: 10k 1%; R_0603
R31, R32: 10R; R_0603
R35: 14k 1%; R_0603
R36: 0R02 0,5% 1W 50ppm; R_2512
R41: 47R; R_0805
R43: DNP; R_0805
T9, T10, T11, T12: BSC028N06NSATMA1; TDSON-8-1
U7, U8: IRS4428SPBF; SOIC-8_3.9x4.9mm_Pitch1.27mm
U24: INA293B2IDBV; SOT-23-5
U27: OPA549; TO-220-11_Vertical_StangeredType1_or_not

Connections:
+5VA: C17.1, C52.1, C53.1, U24.3 (V+); also elsewhere on the board
+15V: C22.1, C23.1, C42.1, C48.1, C78.1, C81.1, D9.1 (K), D20.1 (K), U7.6 (V+), U8.6 (V+), U27.10 (V+), U27.11 (V+); also elsewhere on the board
/CUR3: C88.2, CUR3.1, R29.1, U24.1; also elsewhere on the board
/DAC3: JP3.1 (A); also elsewhere on the board
/DIR3: R22.2, R25.2; also elsewhere on the board
/ES3: U27.9 (E/S); also elsewhere on the board
/Power amplifier 3/G1: R26.1, T9.4 (G)
/Power amplifier 3/G2: R33.1, T11.4 (G)
/Power amplifier 3/G3: R27.1, T10.4 (G)
/Power amplifier 3/G4: R30.1, T12.4 (G)
/Power amplifier 3/S1: D35.2 (A), D36.1 (K), J3.1, T9.1 (S), T9.2 (S), T9.3 (S), T10.5 (D)
/Power amplifier 3/S2: D37.2 (A), D38.1 (K), J3.2, T11.1 (S), T11.2 (S), T11.3 (S), T12.5 (D)
GND: C17.2, C22.2, C23.2, C42.2, C48.2, C52.2, C53.2, C58.1, C78.2, C81.2, D9.2 (A), D19.3 (A), D36.2 (A), D38.2 (A), R35.1, T10.1 (S), T10.2 (S), T10.3 (S), T12.1 (S), T12.2 (S), T12.3 (S), U7.3 (GND), U8.3 (GND), U24.2 (GND), U27.5 (V-), U27.6 (REF), U27.7 (V-); also elsewhere on the board
unnamed: C40.1, D20.2 (A), R31.2, R36.1, R43.1, U27.1, U27.2
unnamed: C40.2, R41.1
unnamed: C55.1, D19.2 (K), R32.1, U24.5 (-)
unnamed: C55.2, D19.1 (K), R31.1, U24.4 (+)
unnamed: C58.2, R35.2, U27.8 (ILIM)
unnamed: C88.1, R29.2, R41.2, R43.2, U27.3 (-)
unnamed: D35.1 (K), D37.1 (K), R32.2, R36.2, T9.5 (D), T11.5 (D)
unnamed: DACIN3.1, JP3.2 (B), R28.2
unnamed: R22.1, U7.2 (IN_A), U7.4 (IN_B)
unnamed: R25.1, U8.2 (IN_A), U8.4 (IN_B)
unnamed: R26.2, U7.7 (~OUT_A)
unnamed: R27.2, U7.5 (OUT_B)
unnamed: R28.1, U27.4 (+)
unnamed: R30.2, U8.7 (~OUT_A)
unnamed: R33.2, U8.5 (OUT_B)

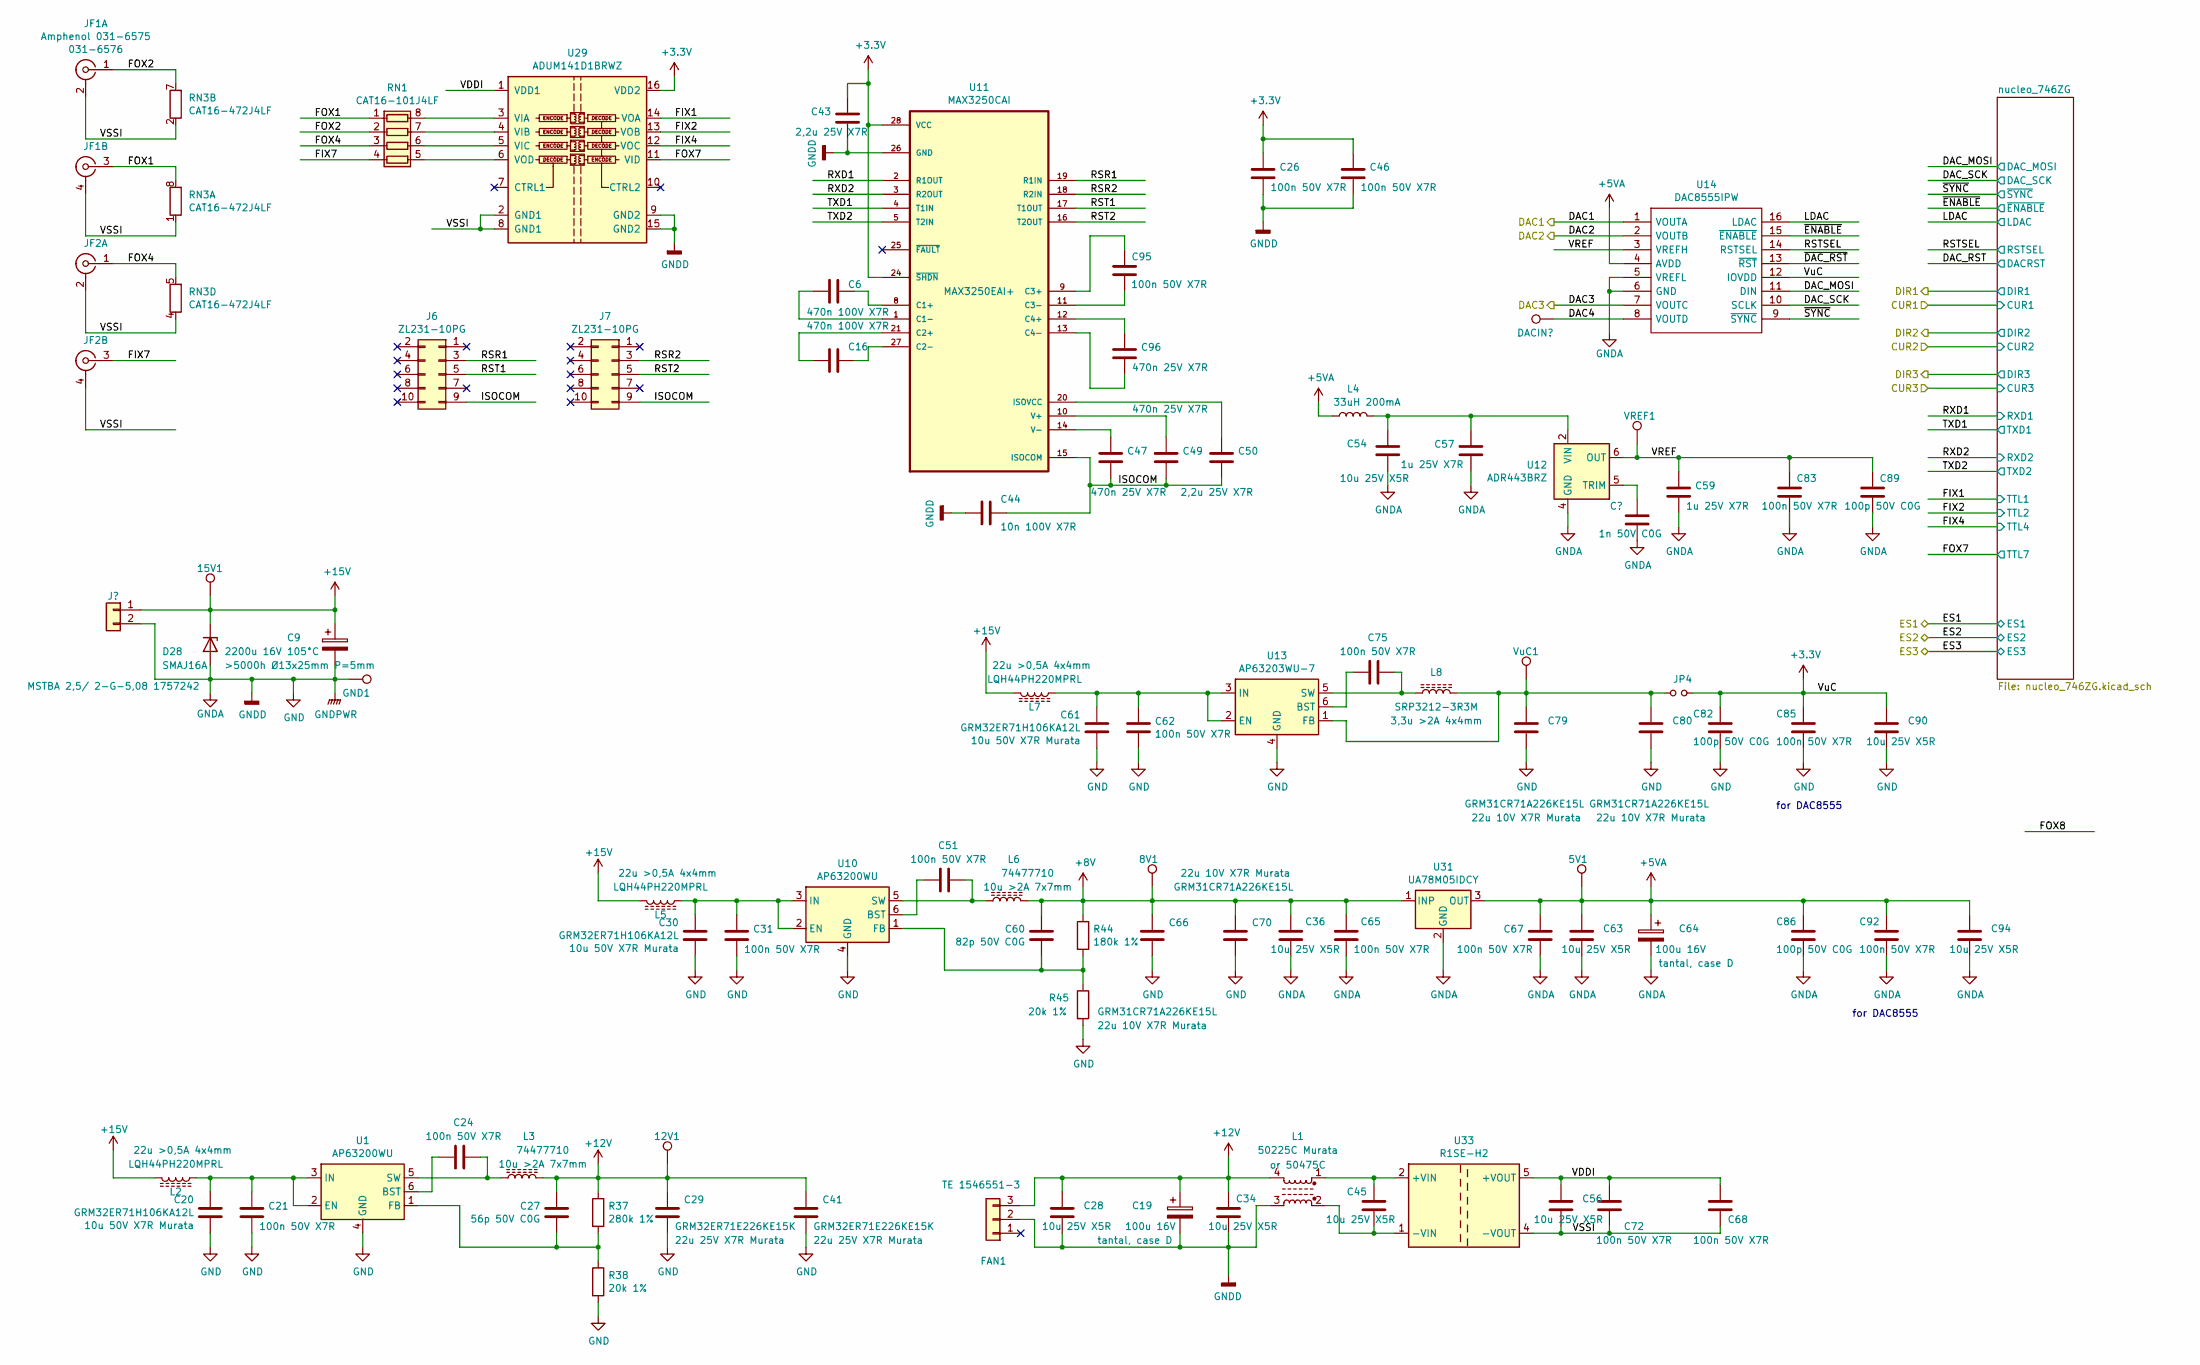
[picture p12: schematic control.kicad_sch, Compensation coils driver]

Parts:
5V1, 8V1, 12V1, 15V1: TestPoint; Test_Point_THTPad_1.5x1.5mm_Drill0.7mm
C1: 1n 50V C0G; C_0603
C6, C16: 470n 100V X7R; C_0805
C9: 2200u 16V 105°C; CP_Radial_D14.0mm_P5.00mm
C19, C64: 100u 16V; CP_Tantalum_Case-D_EIA-7343-31_Reflow
C20, C30, C61: GRM32ER71H106KA12L; C_1210
C21, C24, C26, C31, C46, C51, C62, C65, C67, C68, C72, C75, C83, C85, C92, C95: 100n 50V X7R; C_0603
C27: 56p 50V C0G; C_0603
C28, C34, C36, C45, C54, C56, C63, C90, C94: 10u 25V X5R; C_0603
C29, C41: GRM32ER71E226KE15K; C_1210
C43, C50: 2,2u 25V X7R; C_0805
C44: 10n 100V X7R; C_0805
C47, C49, C96: 470n 25V X7R; C_0603
C57, C59: 1u 25V X7R; C_0603
C60: 82p 50V C0G; C_0603
C66, C70, C79, C80: GRM31CR71A226KE15L; C_1206
C82, C86, C89: 100p 50V C0G; C_0603
D28: SMAJ16A; D_SMA
DACIN4: TestPoint; Test_Point_THTPad_1.5x1.5mm_Drill0.7mm
FAN1: TE 1546551-3; TerminalBlock_4UCON_19963_03x3.5mm_Straight
GND1: TestPoint; Test_Point_Bridge_Pitch2.54mm_Drill1.0mm
J4: MSTBA 2,5/ 2-G-5,08 1757242; PhoenixContact_MSTBA-G_02x5.08mm_Angled
J6, J7: ZL231-10PG; IDC-Header_2x05_Pitch2.54mm_Straight
JF1, JF2: Amphenol 031-6575; BNC_Amphenol_031-6575_Horizontal
JP4: Jumper_NO_Small; GS2_small
L1: 50225C Murata; L_CommonMode_Murata_5000
L2, L5, L7: LQH44PH220MPRL; L_MURATA_LQH44
L3, L6: 74477710; L_Wuerth_HCM-7050
L4: 33uH 200mA; L_0805
L8: SRP3212-3R3M; L_Bourns_SRP3212
R37: 280k 1%; R_0603
R38, R45: 20k 1%; R_0603
R44: 180k 1%; R_0603
RN1: CAT16-101J4LF; R_Array_Concave_4x0603
RN3: CAT16-472J4LF; R_Array_Concave_4x0603
U1, U10: AP63200WU; TSOT-23-6
U11: MAX3250CAI; SSOP-28_5.3x10.2mm_Pitch0.65mm
U12: ADR443BRZ; SOIC-8_3.9x4.9mm_P1.27mm
U13: AP63203WU-7; TSOT-23-6
U14: DAC8555IPW; TSSOP-16_4.4x5mm_Pitch0.65mm
U29: ADUM141D1BRWZ; SOIC-16W_7.5x10.3mm_Pitch1.27mm
U31: UA78M05IDCY; SOT-223-3_TabPin2
U33: R1SE-H2; SOIC-5_8-10.7x12.75_Pitch2.54
VREF1: TestPoint; Test_Point_THTPad_1.5x1.5mm_Drill0.7mm
VuC1: TestPoint; Test_Point_THTPad_1.5x1.5mm_Drill0.7mm

Connections:
+5VA: 5V1.1, C63.1, C64.1, C67.1, C86.1, C92.1, C94.1, L4.1, U14.4 (AVDD), U31.3 (OUT); also elsewhere on the board
+8V: 8V1.1, C36.1, C60.1, C65.1, C66.1, C70.1, L6.1, R44.1, U31.1 (INP)
+12V: 12V1.1, C19.1, C27.1, C28.1, C29.1, C34.1, C41.1, FAN1.3, L1.4, L3.1, R37.1
+15V: 15V1.1, C9.1, D28.1 (K), J4.1, L2.2, L5.2, L7.2; also elsewhere on the board
/DAC1: U14.1 (VOUTA); also elsewhere on the board
/DAC2: U14.2 (VOUTB); also elsewhere on the board
/DAC3: U14.7 (VOUTC); also elsewhere on the board
/controller+DAC/DAC4: DACIN4.1, U14.8 (VOUTD)
/controller+DAC/DAC_MOSI: U14.11 (DIN); also elsewhere on the board
/controller+DAC/DAC_SCK: U14.10 (SCLK); also elsewhere on the board
/controller+DAC/FIX1: U29.14 (VOA); also elsewhere on the board
/controller+DAC/FIX2: U29.13 (VOB); also elsewhere on the board
/controller+DAC/FIX4: U29.12 (VOC); also elsewhere on the board
/controller+DAC/FIX7: JF2.3 (In2), RN1.4 (R4.1)
/controller+DAC/FOX1: JF1.3 (In2), RN1.1 (R1.1), RN3.8 (R1.2)
/controller+DAC/FOX2: JF1.1 (In1), RN1.2 (R2.1), RN3.7 (R2.2)
/controller+DAC/FOX4: JF2.1 (In1), RN1.3 (R3.1), RN3.5 (R4.2)
/controller+DAC/FOX7: U29.11 (VID); also elsewhere on the board
/controller+DAC/ISOCOM: C44.1, C47.2, C49.2, C50.2, J6.9, J7.9, U11.15 (ISOCOM)
/controller+DAC/LDAC: U14.16 (LDAC); also elsewhere on the board
/controller+DAC/RSR1: J6.3, U11.19 (R1IN)
/controller+DAC/RSR2: J7.3, U11.18 (R2IN)
/controller+DAC/RST1: J6.5, U11.17 (T1OUT)
/controller+DAC/RST2: J7.5, U11.16 (T2OUT)
/controller+DAC/RSTSEL: U14.14 (RSTSEL); also elsewhere on the board
/controller+DAC/RXD1: U11.2 (R1OUT); also elsewhere on the board
/controller+DAC/RXD2: U11.3 (R2OUT); also elsewhere on the board
/controller+DAC/TXD1: U11.4 (T1IN); also elsewhere on the board
/controller+DAC/TXD2: U11.5 (T2IN); also elsewhere on the board
/controller+DAC/VDDI: C56.1, C68.1, C72.1, U29.1 (VDD1), U33.5 (+VOUT)
/controller+DAC/VREF: C59.1, C83.1, C89.1, U12.6 (OUT), U14.3 (VREFH), VREF1.1
/controller+DAC/VSSI: C56.2, C68.2, C72.2, JF1.2 (Ext1), JF1.4 (Ext2), JF2.2 (Ext1), JF2.4 (Ext2), RN3.1 (R1.1), RN3.2 (R2.1), RN3.4 (R4.1), U29.2 (GND1), U29.8 (GND1), U33.4 (-VOUT)
/controller+DAC/~ENABLE: U14.15 (~ENABLE); also elsewhere on the board
/controller+DAC/~SYNC: U14.9 (~SYNC); also elsewhere on the board
GND: C1.1, C9.2, C19.2, C20.2, C21.2, C26.2, C28.2, C29.2, C30.2, C31.2, C34.2, C36.2, C41.2, C43.2, C44.2, C46.2, C54.2, C57.2, C59.2, C61.2, C62.2, C63.2, C64.2, C65.2, C66.2, C67.2, C70.2, C79.2, C80.2, C82.2, C83.2, C85.2, C86.2, C89.2, C90.2, C92.2, C94.2, D28.2 (A), FAN1.2, GND1.1, J4.2, L1.3, R38.2, R45.2, U1.4 (GND), U10.4 (GND), U11.26 (GND), U12.4 (GND), U13.4 (GND), U14.5 (VREFL), U14.6 (GND), U29.9 (GND2), U29.15 (GND2), U31.2 (GND); also elsewhere on the board
unnamed: C1.2, U12.5 (TRIM)
unnamed: C6.1, U11.8 (C1+)
unnamed: C6.2, U11.1 (C1-)
unnamed: C16.1, U11.27 (C2-)
unnamed: C16.2, U11.21 (C2+)
unnamed: C20.1, C21.1, L2.1, U1.2 (EN), U1.3 (IN)
unnamed: C24.1, L3.2, U1.5 (SW)
unnamed: C24.2, U1.6 (BST)
unnamed: C27.2, R37.2, R38.1, U1.1 (FB)
unnamed: C30.1, C31.1, L5.1, U10.2 (EN), U10.3 (IN)
unnamed: C45.1, L1.1, U33.2 (+VIN)
unnamed: C45.2, L1.2, U33.1 (-VIN)
unnamed: C47.1, U11.14 (V-)
unnamed: C49.1, U11.10 (V+)
unnamed: C50.1, U11.20 (ISOVCC)
unnamed: C51.1, L6.2, U10.5 (SW)
unnamed: C51.2, U10.6 (BST)
unnamed: C54.1, C57.1, L4.2, U12.2 (VIN)
unnamed: C60.2, R44.2, R45.1, U10.1 (FB)
unnamed: C61.1, C62.1, L7.1, U13.2 (EN), U13.3 (IN)
unnamed: C75.1, L8.2, U13.5 (SW)
unnamed: C75.2, U13.6 (BST)
unnamed: C79.1, C80.1, JP4.2, L8.1, U13.1 (FB), VuC1.1
unnamed: C95.1, U11.9 (C3+)
unnamed: C95.2, U11.11 (C3-)
unnamed: C96.1, U11.12 (C4+)
unnamed: C96.2, U11.13 (C4-)
unnamed: RN1.5 (R4.2), U29.6 (VOD)
unnamed: RN1.6 (R3.2), U29.5 (VIC)
unnamed: RN1.7 (R2.2), U29.4 (VIB)
unnamed: RN1.8 (R1.2), U29.3 (VIA)

Notes on the sheet:
for DAC8555

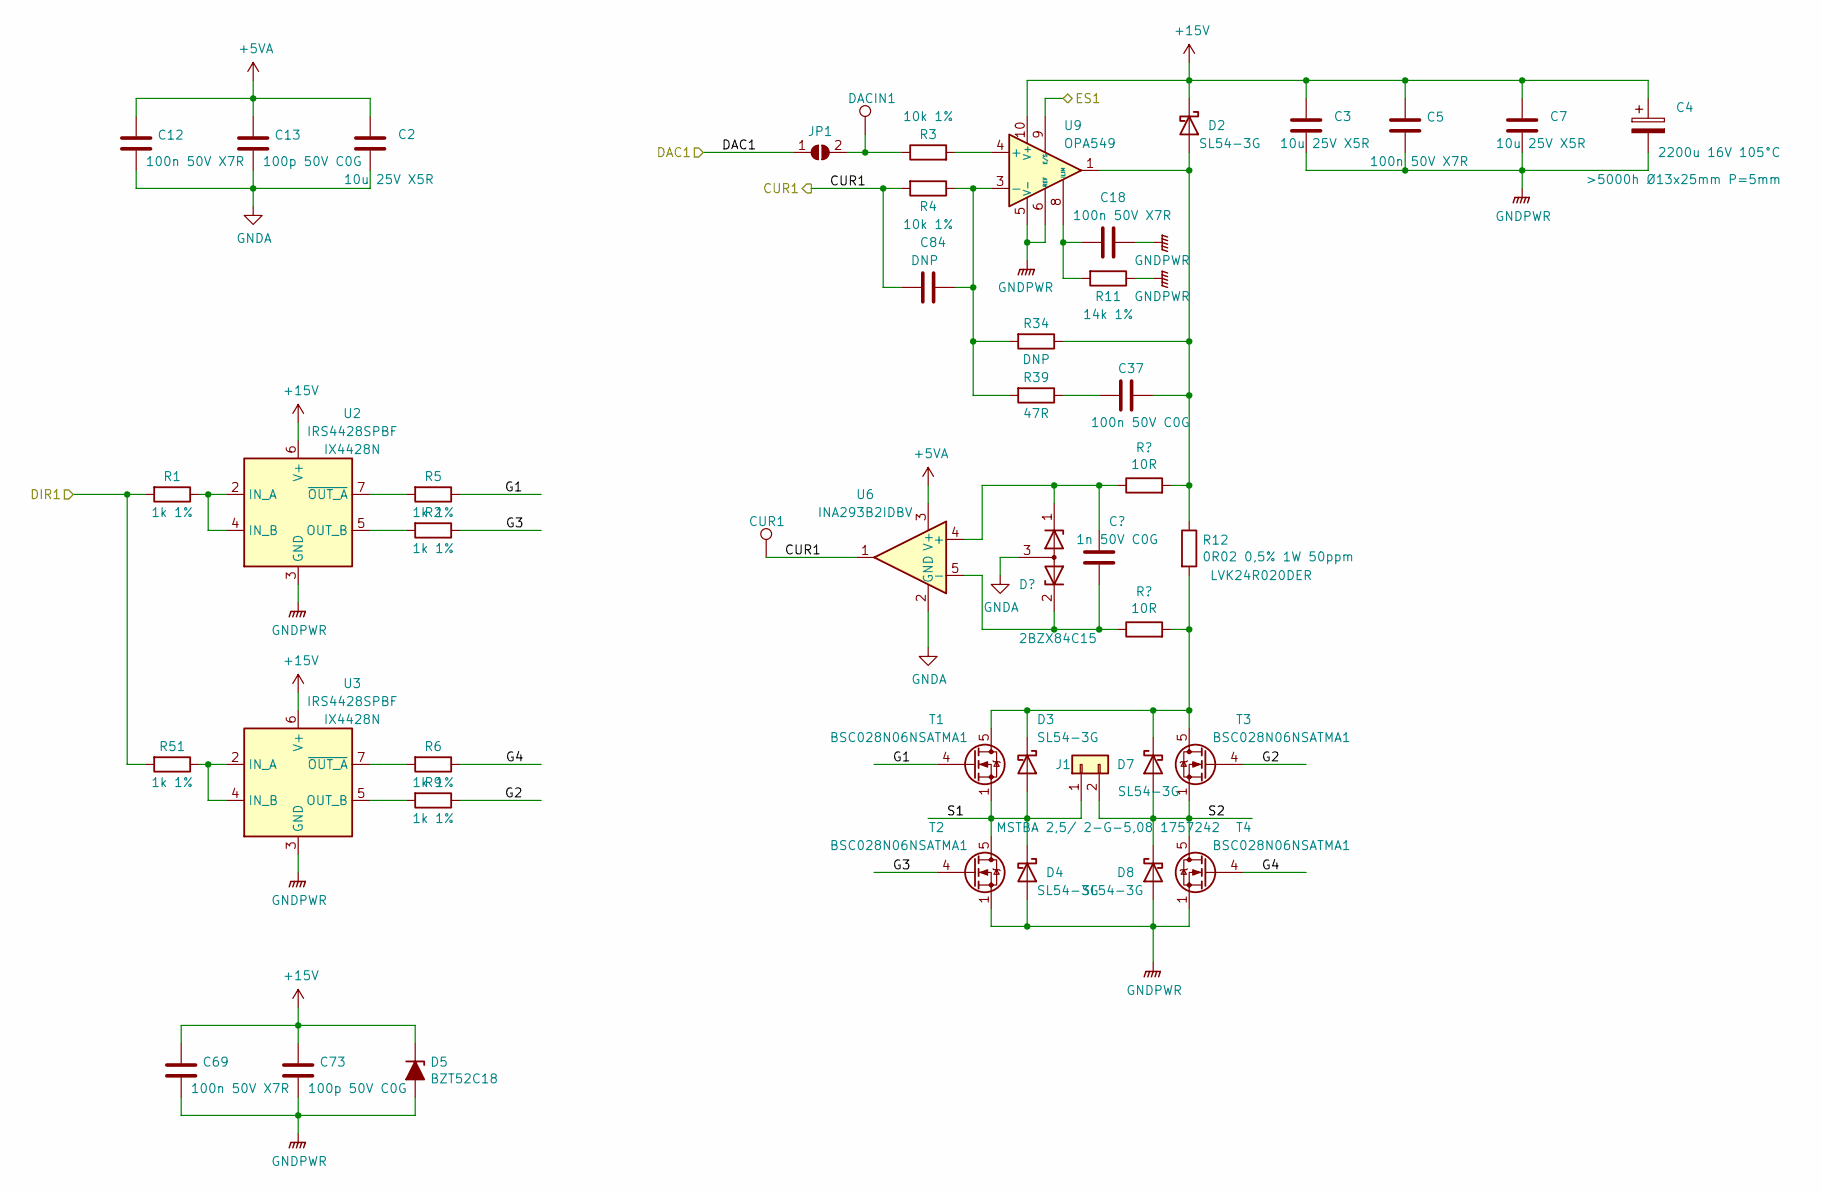
[picture p13: schematic power1.kicad_sch, Compensation coils driver]

Parts:
C2, C3, C7: 10u 25V X5R; C_0603
C4: 2200u 16V 105°C; CP_Radial_D14.0mm_P5.00mm
C5, C12, C18, C69: 100n 50V X7R; C_0603
C13, C73: 100p 50V C0G; C_0603
C15: 1n 50V C0G; C_0603
C37: 100n 50V C0G; C_1206
C84: DNP; C_0603
CUR1: TestPoint; Test_Point_THTPad_1.5x1.5mm_Drill0.7mm
D1: 2BZX84C15; SOT-23
D2, D3, D4, D7, D8: SL54-3G; D_SMB
D5: BZT52C18; D_SOD-123
DACIN1: TestPoint; Test_Point_THTPad_1.5x1.5mm_Drill0.7mm
J1: MSTBA 2,5/ 2-G-5,08 1757242; PhoenixContact_MSTBA-G_02x5.08mm_Angled
JP1: SolderJumper_2_Open; GS2_small
R1, R2, R5, R6, R9, R51: 1k 1%; R_0603
R3, R4: 10k 1%; R_0603
R7, R8: 10R; R_0603
R11: 14k 1%; R_0603
R12: 0R02 0,5% 1W 50ppm; R_2512
R34: DNP; R_0805
R39: 47R; R_0805
T1, T2, T3, T4: BSC028N06NSATMA1; TDSON-8-1
U2, U3: IRS4428SPBF; SOIC-8_3.9x4.9mm_Pitch1.27mm
U6: INA293B2IDBV; SOT-23-5
U9: OPA549; TO-220-11_Vertical_StangeredType1_or_not

Connections:
+5VA: C2.1, C12.1, C13.1, U6.3 (V+); also elsewhere on the board
+15V: C3.1, C4.1, C5.1, C7.1, C69.1, C73.1, D2.1 (K), D5.1 (K), U2.6 (V+), U3.6 (V+), U9.10 (V+), U9.11 (V+); also elsewhere on the board
/CUR1: C84.2, CUR1.1, R4.2, U6.1; also elsewhere on the board
/DAC1: JP1.1 (A); also elsewhere on the board
/DIR1: R1.2, R51.2; also elsewhere on the board
/ES1: U9.9 (E/S); also elsewhere on the board
/Power amplifier 1/G1: R5.1, T1.4 (G)
/Power amplifier 1/G2: R9.1, T3.4 (G)
/Power amplifier 1/G3: R2.1, T2.4 (G)
/Power amplifier 1/G4: R6.1, T4.4 (G)
/Power amplifier 1/S1: D3.2 (A), D4.1 (K), J1.1, T1.1 (S), T1.2 (S), T1.3 (S), T2.5 (D)
/Power amplifier 1/S2: D7.2 (A), D8.1 (K), J1.2, T3.1 (S), T3.2 (S), T3.3 (S), T4.5 (D)
GND: C2.2, C3.2, C4.2, C5.2, C7.2, C12.2, C13.2, C18.1, C69.2, C73.2, D1.3 (A), D4.2 (A), D5.2 (A), D8.2 (A), R11.1, T2.1 (S), T2.2 (S), T2.3 (S), T4.1 (S), T4.2 (S), T4.3 (S), U2.3 (GND), U3.3 (GND), U6.2 (GND), U9.5 (V-), U9.6 (REF), U9.7 (V-); also elsewhere on the board
unnamed: C15.1, D1.2 (K), R8.1, U6.5 (-)
unnamed: C15.2, D1.1 (K), R7.1, U6.4 (+)
unnamed: C18.2, R11.2, U9.8 (ILIM)
unnamed: C37.1, D2.2 (A), R7.2, R12.1, R34.1, U9.1, U9.2
unnamed: C37.2, R39.1
unnamed: C84.1, R4.1, R34.2, R39.2, U9.3 (-)
unnamed: D3.1 (K), D7.1 (K), R8.2, R12.2, T1.5 (D), T3.5 (D)
unnamed: DACIN1.1, JP1.2 (B), R3.1
unnamed: R1.1, U2.2 (IN_A), U2.4 (IN_B)
unnamed: R2.2, U2.5 (OUT_B)
unnamed: R3.2, U9.4 (+)
unnamed: R5.2, U2.7 (~OUT_A)
unnamed: R6.2, U3.7 (~OUT_A)
unnamed: R9.2, U3.5 (OUT_B)
unnamed: R51.1, U3.2 (IN_A), U3.4 (IN_B)

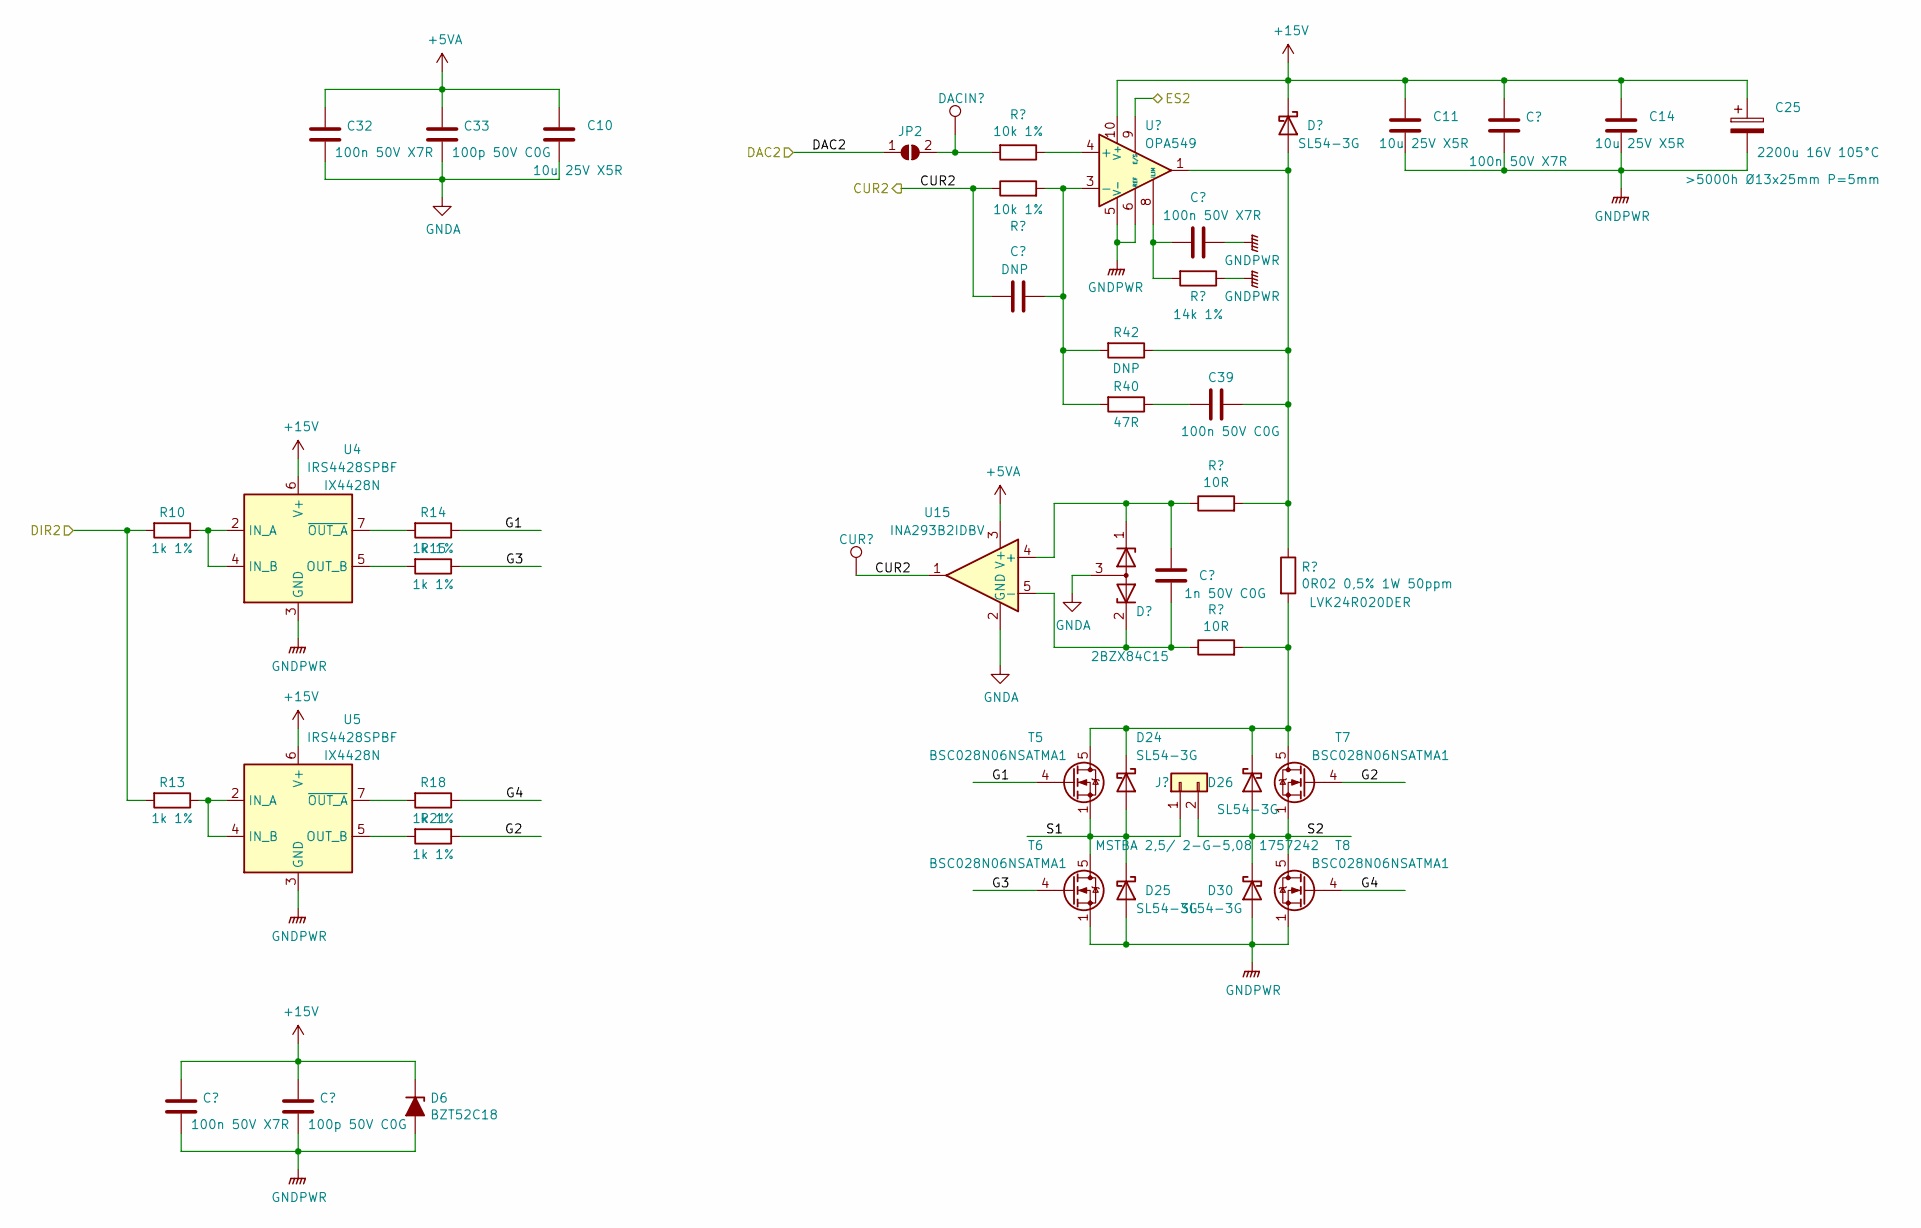
[picture p14: schematic power2.kicad_sch, Compensation coils driver]

Parts:
C8, C32, C38, C74: 100n 50V X7R; C_0603
C10, C11, C14: 10u 25V X5R; C_0603
C25: 2200u 16V 105°C; CP_Radial_D14.0mm_P5.00mm
C33, C76: 100p 50V C0G; C_0603
C35: 1n 50V C0G; C_0603
C39: 100n 50V C0G; C_1206
C87: DNP; C_0603
CUR2: TestPoint; Test_Point_THTPad_1.5x1.5mm_Drill0.7mm
D6: BZT52C18; D_SOD-123
D10: 2BZX84C15; SOT-23
D11, D24, D25, D26, D30: SL54-3G; D_SMB
DACIN2: TestPoint; Test_Point_THTPad_1.5x1.5mm_Drill0.7mm
J2: MSTBA 2,5/ 2-G-5,08 1757242; PhoenixContact_MSTBA-G_02x5.08mm_Angled
JP2: SolderJumper_2_Open; GS2_small
R10, R13, R14, R15, R18, R21: 1k 1%; R_0603
R16, R17: 10k 1%; R_0603
R19, R20: 10R; R_0603
R23: 14k 1%; R_0603
R24: 0R02 0,5% 1W 50ppm; R_2512
R40: 47R; R_0805
R42: DNP; R_0805
T5, T6, T7, T8: BSC028N06NSATMA1; TDSON-8-1
U4, U5: IRS4428SPBF; SOIC-8_3.9x4.9mm_Pitch1.27mm
U15: INA293B2IDBV; SOT-23-5
U18: OPA549; TO-220-11_Vertical_StangeredType1_or_not

Connections:
+5VA: C10.1, C32.1, C33.1, U15.3 (V+); also elsewhere on the board
+15V: C8.1, C11.1, C14.1, C25.1, C74.1, C76.1, D6.1 (K), D11.1 (K), U4.6 (V+), U5.6 (V+), U18.10 (V+), U18.11 (V+); also elsewhere on the board
/CUR2: C87.2, CUR2.1, R17.1, U15.1; also elsewhere on the board
/DAC2: JP2.1 (A); also elsewhere on the board
/DIR2: R10.2, R13.2; also elsewhere on the board
/ES2: U18.9 (E/S); also elsewhere on the board
/Power amplifier 2/G1: R14.1, T5.4 (G)
/Power amplifier 2/G2: R21.1, T7.4 (G)
/Power amplifier 2/G3: R15.1, T6.4 (G)
/Power amplifier 2/G4: R18.1, T8.4 (G)
/Power amplifier 2/S1: D24.2 (A), D25.1 (K), J2.1, T5.1 (S), T5.2 (S), T5.3 (S), T6.5 (D)
/Power amplifier 2/S2: D26.2 (A), D30.1 (K), J2.2, T7.1 (S), T7.2 (S), T7.3 (S), T8.5 (D)
GND: C8.2, C10.2, C11.2, C14.2, C25.2, C32.2, C33.2, C38.1, C74.2, C76.2, D6.2 (A), D10.3 (A), D25.2 (A), D30.2 (A), R23.1, T6.1 (S), T6.2 (S), T6.3 (S), T8.1 (S), T8.2 (S), T8.3 (S), U4.3 (GND), U5.3 (GND), U15.2 (GND), U18.5 (V-), U18.6 (REF), U18.7 (V-); also elsewhere on the board
unnamed: C35.1, D10.2 (K), R20.1, U15.5 (-)
unnamed: C35.2, D10.1 (K), R19.1, U15.4 (+)
unnamed: C38.2, R23.2, U18.8 (ILIM)
unnamed: C39.1, D11.2 (A), R19.2, R24.1, R42.1, U18.1, U18.2
unnamed: C39.2, R40.1
unnamed: C87.1, R17.2, R40.2, R42.2, U18.3 (-)
unnamed: D24.1 (K), D26.1 (K), R20.2, R24.2, T5.5 (D), T7.5 (D)
unnamed: DACIN2.1, JP2.2 (B), R16.2
unnamed: R10.1, U4.2 (IN_A), U4.4 (IN_B)
unnamed: R13.1, U5.2 (IN_A), U5.4 (IN_B)
unnamed: R14.2, U4.7 (~OUT_A)
unnamed: R15.2, U4.5 (OUT_B)
unnamed: R16.1, U18.4 (+)
unnamed: R18.2, U5.7 (~OUT_A)
unnamed: R21.2, U5.5 (OUT_B)
