KLFAMO/current3Av2/kicad/current3Av2.kicad_pcb

## KiCad design kicad/current3Av2.kicad_pcb (continued)

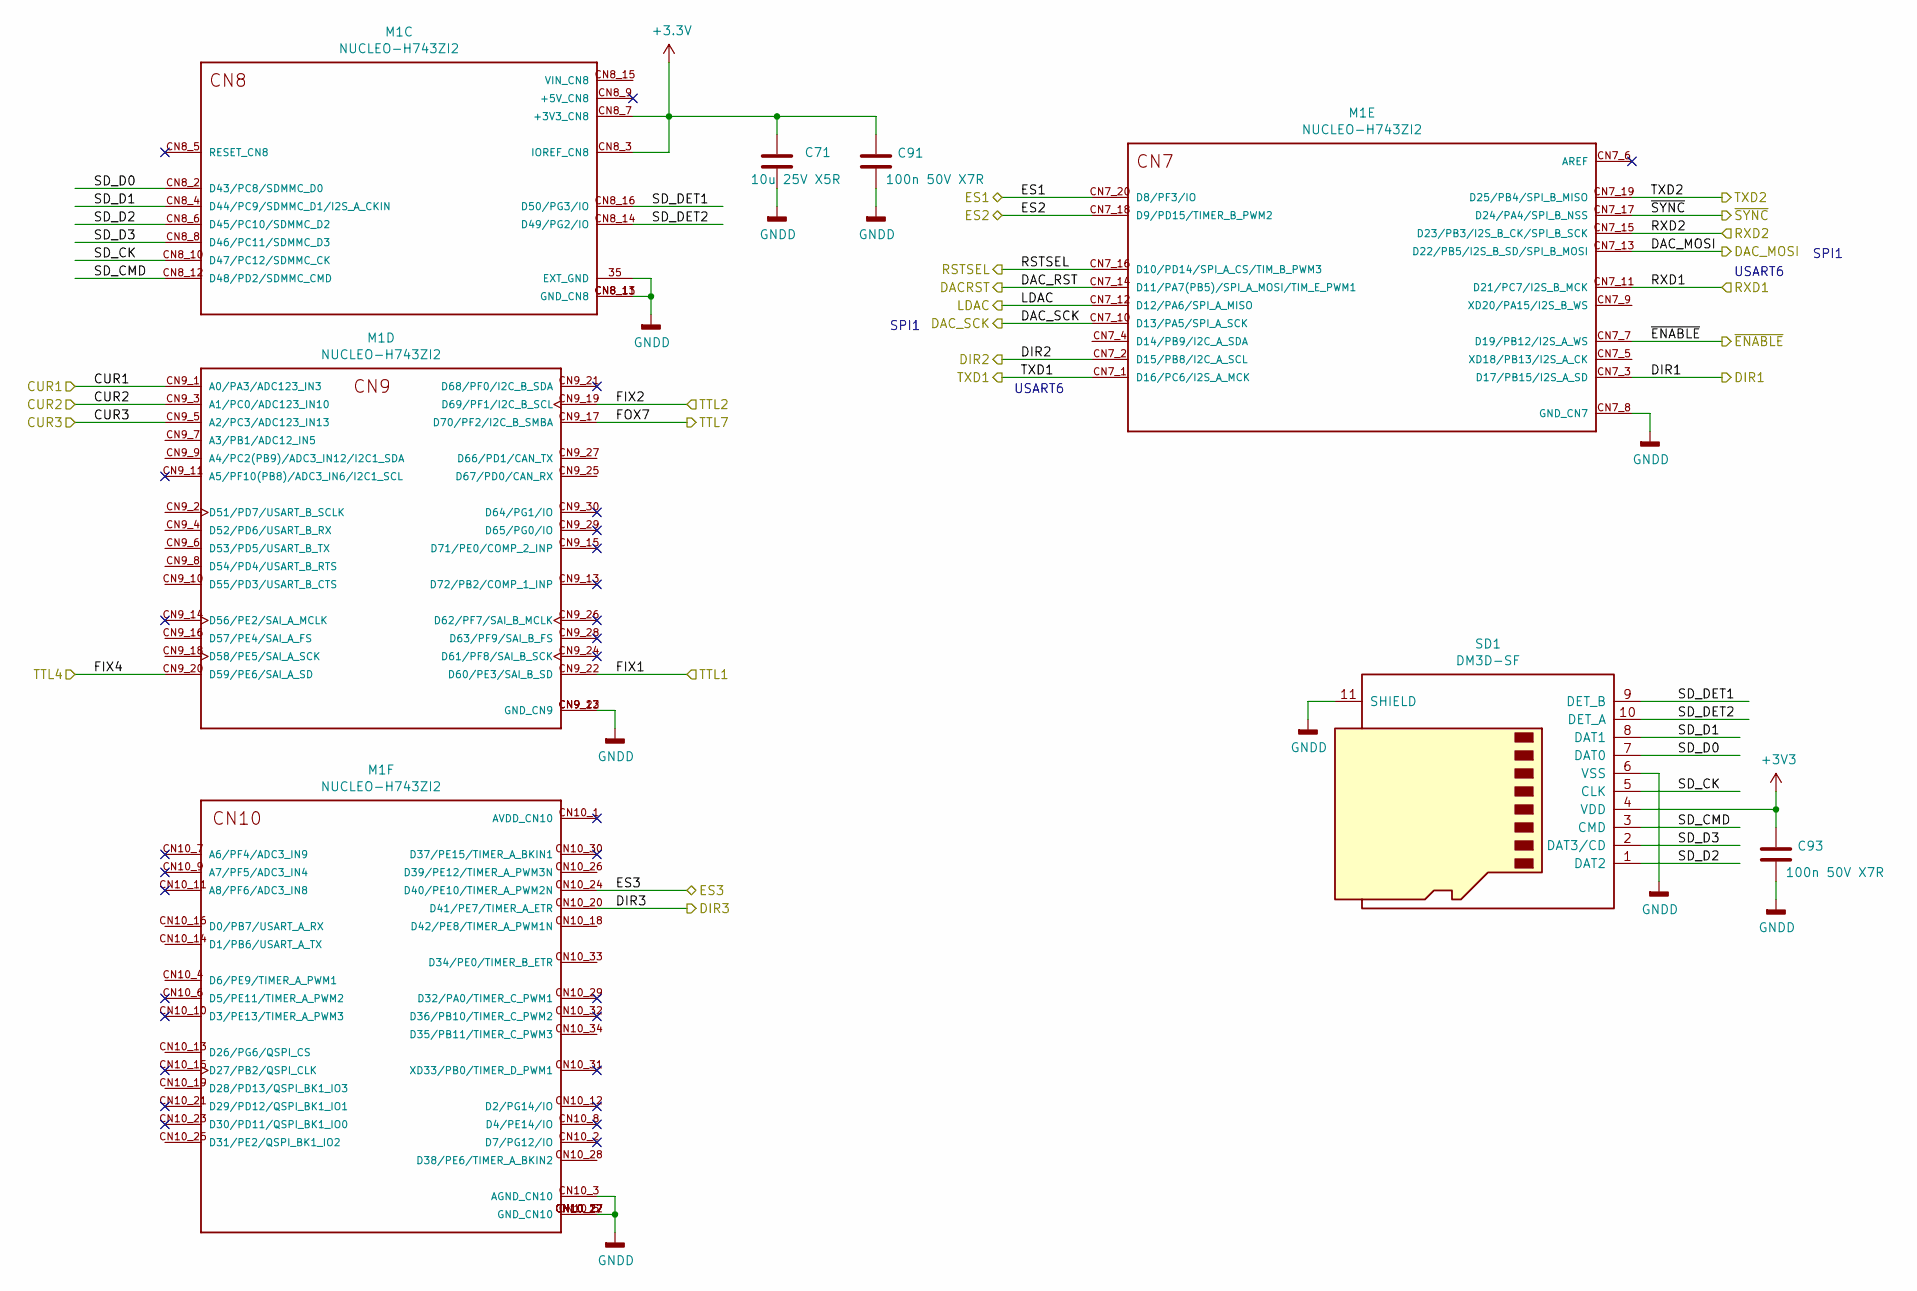
[picture p15: schematic nucleo_746ZG.kicad_sch, Compensation coils driver]

Parts:
C71: 10u 25V X5R; C_0603
C91, C93: 100n 50V X7R; C_0603
M1: NUCLEO-H743ZI2; MODULE_NUCLEO-F746ZG_mini_M
SD1: DM3D-SF; Hirose_DM3D-SF

Connections:
/CUR1: M1.CN9_1 (A0/PA3/ADC123_IN3); also elsewhere on the board
/CUR2: M1.CN9_3 (A1/PC0/ADC123_IN10); also elsewhere on the board
/CUR3: M1.CN9_5 (A2/PC3/ADC123_IN13); also elsewhere on the board
/DIR1: M1.CN7_3 (D17/PB15/I2S_A_SD); also elsewhere on the board
/DIR2: M1.CN7_2 (D15/PB8/I2C_A_SCL); also elsewhere on the board
/DIR3: M1.CN10_20 (D41/PE7/TIMER_A_ETR); also elsewhere on the board
/ES1: M1.CN7_20 (D8/PF3/IO); also elsewhere on the board
/ES2: M1.CN7_18 (D9/PD15/TIMER_B_PWM2); also elsewhere on the board
/ES3: M1.CN10_24 (D40/PE10/TIMER_A_PWM2N); also elsewhere on the board
/controller+DAC/DAC_MOSI: M1.CN7_13 (D22/PB5/I2S_B_SD/SPI_B_MOSI); also elsewhere on the board
/controller+DAC/DAC_SCK: M1.CN7_10 (D13/PA5/SPI_A_SCK); also elsewhere on the board
/controller+DAC/FIX1: M1.CN9_22 (D60/PE3/SAI_B_SD); also elsewhere on the board
/controller+DAC/FIX2: M1.CN9_19 (D69/PF1/I2C_B_SCL); also elsewhere on the board
/controller+DAC/FIX4: M1.CN9_20 (D59/PE6/SAI_A_SD); also elsewhere on the board
/controller+DAC/FOX7: M1.CN9_17 (D70/PF2/I2C_B_SMBA); also elsewhere on the board
/controller+DAC/LDAC: M1.CN7_12 (D12/PA6/SPI_A_MISO); also elsewhere on the board
/controller+DAC/RSTSEL: M1.CN7_16 (D10/PD14/SPI_A_CS/TIM_B_PWM3); also elsewhere on the board
/controller+DAC/RXD1: M1.CN7_11 (D21/PC7/I2S_B_MCK); also elsewhere on the board
/controller+DAC/RXD2: M1.CN7_15 (D23/PB3/I2S_B_CK/SPI_B_SCK); also elsewhere on the board
/controller+DAC/TXD1: M1.CN7_1 (D16/PC6/I2S_A_MCK); also elsewhere on the board
/controller+DAC/TXD2: M1.CN7_19 (D25/PB4/SPI_B_MISO); also elsewhere on the board
/controller+DAC/nucleo_746ZG/SD_CK: M1.CN8_10 (D47/PC12/SDMMC_CK), SD1.5 (CLK)
/controller+DAC/nucleo_746ZG/SD_CMD: M1.CN8_12 (D48/PD2/SDMMC_CMD), SD1.3 (CMD)
/controller+DAC/nucleo_746ZG/SD_D0: M1.CN8_2 (D43/PC8/SDMMC_D0), SD1.7 (DAT0)
/controller+DAC/nucleo_746ZG/SD_D1: M1.CN8_4 (D44/PC9/SDMMC_D1/I2S_A_CKIN), SD1.8 (DAT1)
/controller+DAC/nucleo_746ZG/SD_D2: M1.CN8_6 (D45/PC10/SDMMC_D2), SD1.1 (DAT2)
/controller+DAC/nucleo_746ZG/SD_D3: M1.CN8_8 (D46/PC11/SDMMC_D3), SD1.2 (DAT3/CD)
/controller+DAC/nucleo_746ZG/SD_DET1: M1.CN8_16 (D50/PG3/IO), SD1.9 (DET_B)
/controller+DAC/nucleo_746ZG/SD_DET2: M1.CN8_14 (D49/PG2/IO), SD1.10 (DET_A)
/controller+DAC/~ENABLE: M1.CN7_7 (D19/PB12/I2S_A_WS); also elsewhere on the board
/controller+DAC/~SYNC: M1.CN7_17 (D24/PA4/SPI_B_NSS); also elsewhere on the board
GND: C71.2, C91.2, C93.2, M1.35 (EXT_GND), M1.CN7_8 (GND_CN7), M1.CN8_11 (GND_CN8), M1.CN8_13 (GND_CN8), M1.CN9_12 (GND_CN9), M1.CN9_23 (GND_CN9), M1.CN10_3 (AGND_CN10), M1.CN10_5 (GND_CN10), M1.CN10_17 (GND_CN10), M1.CN10_22 (GND_CN10), M1.CN10_27 (GND_CN10), SD1.6 (VSS), SD1.11 (SHIELD); also elsewhere on the board

Notes on the sheet:
SPI1
USART6

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
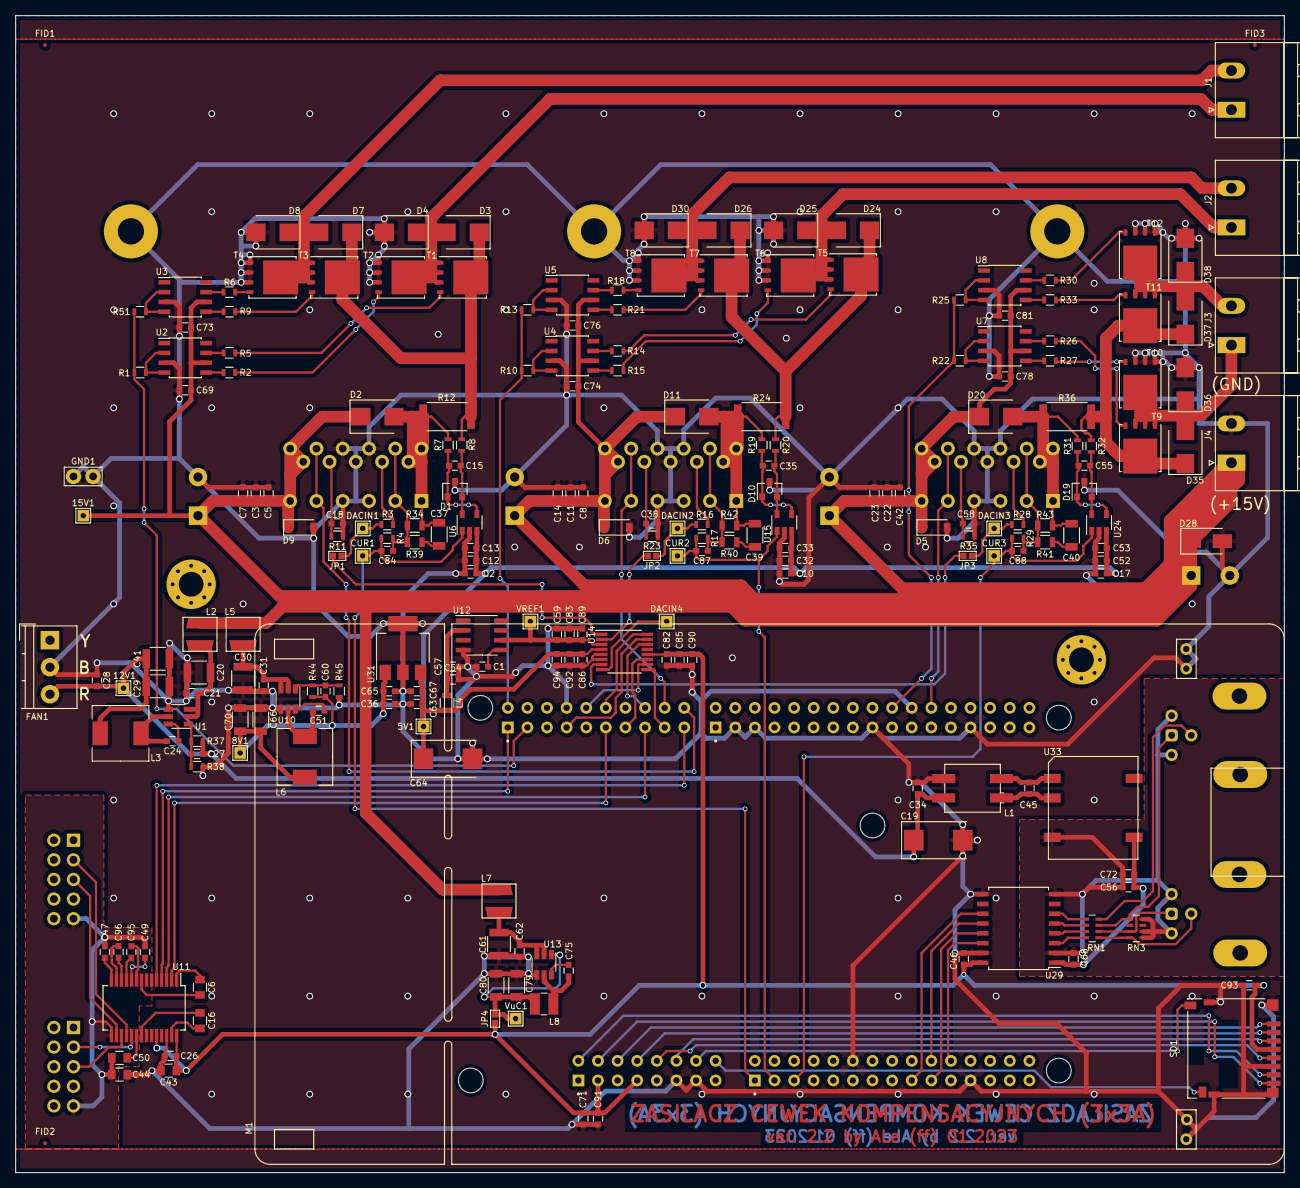
[picture p16: board current3Av2.kicad_pcb from above]

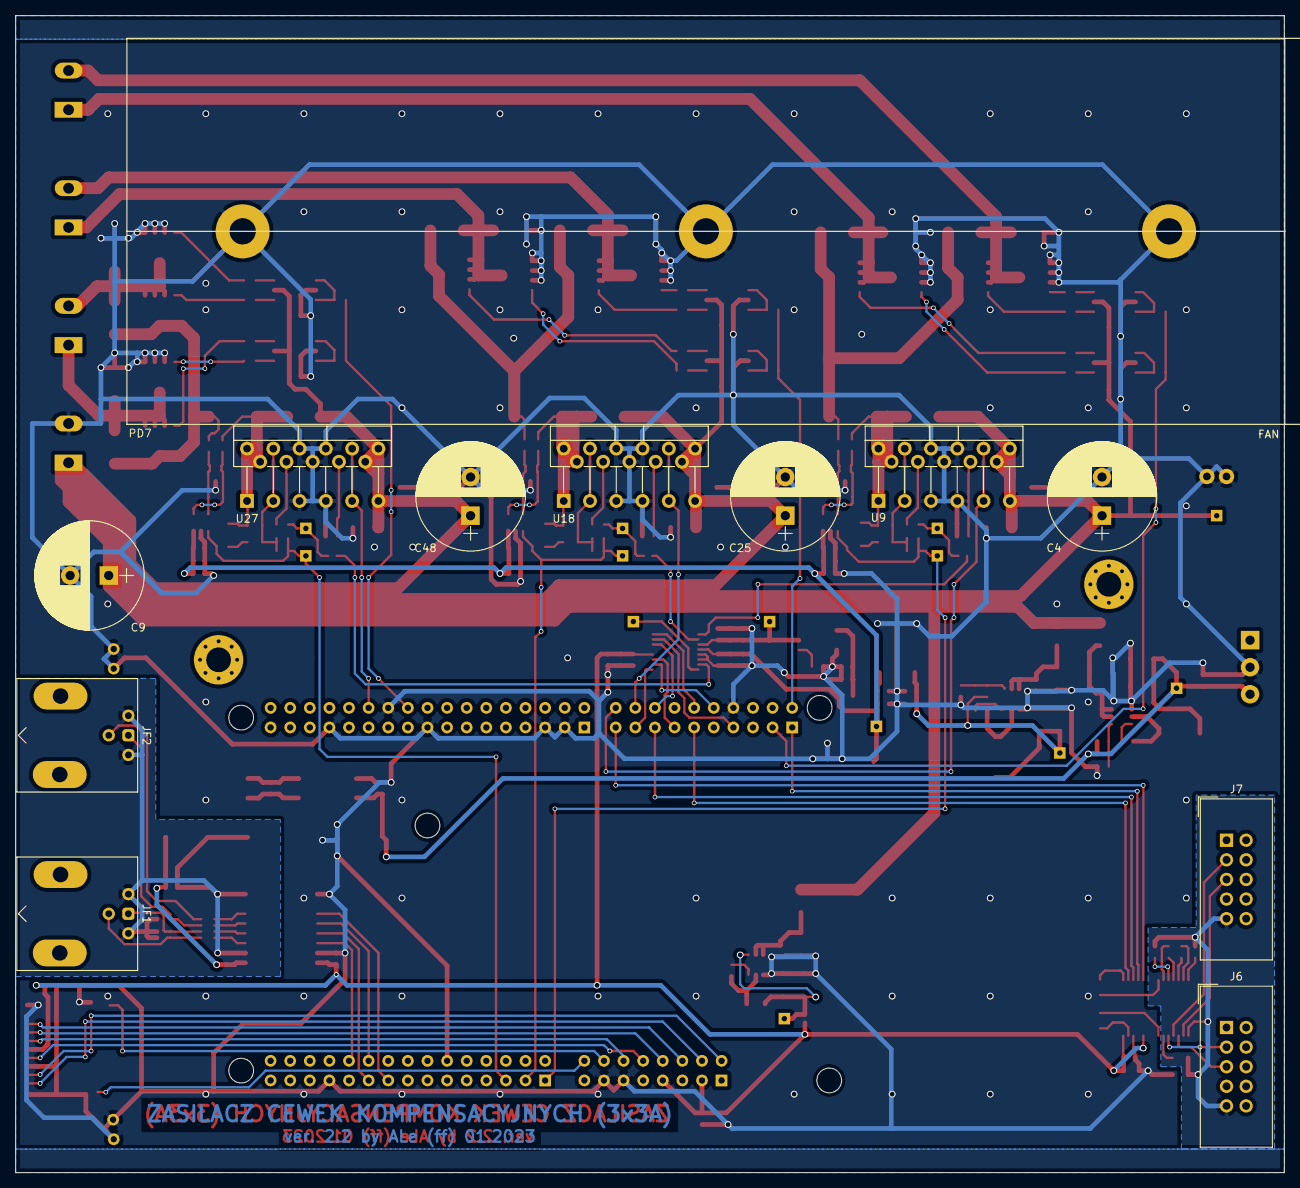
[picture p17: board current3Av2.kicad_pcb from below]

Board: 2 copper layers, 164.3 x 149.9 mm, 241 parts (12 on the bottom side), 147 nets.
