KLFAMO/current3Av2/kicad/C3Av2_nucleo_new/C3Av2_nucleo_new.ioc

Mcu.UserName=STM32H743ZITx
PA1.Signal=ETH_REF_CLK
PA11.Signal=USB_OTG_FS_DM
PA12.Signal=USB_OTG_FS_DP
PA2.Signal=ETH_MDIO
PA3.GPIO_Label=CUR1(ADC1)
PA3.Signal=ADCx_INP15
PA4.GPIO_Label=DAC1_CS(out)
PA4.Signal=GPIO_Output
PA5.GPIO_Label=DAC_SCK(SPI1)
PA5.Signal=SPI1_SCK
PA6.GPIO_Label=DAC3_CS(out)
PA6.Signal=GPIO_Output
PA7.Signal=ETH_CRS_DV
PA8.Signal=USB_OTG_FS_SOF
PA9.Signal=USB_OTG_FS_VBUS
PB0.GPIO_Label=LD1 [Green Led]
PB0.Signal=GPIO_Output
PB11.GPIO_Label=FIX2(EXTI11)
PB11.Signal=GPXTI11
PB12.GPIO_Label=DAC2_CS(out)
PB12.Signal=GPIO_Output
PB13.Signal=ETH_TXD1
PB14.GPIO_Label=LD3 [Red Led]
PB14.Signal=GPIO_Output
PB15.GPIO_Label=DIR1(out)
PB15.Signal=GPIO_Output
PB5.GPIO_Label=DAC_MOSI(SPI1)
PB5.Signal=SPI1_MOSI
PB6.GPIO_Label=TDX2
PB6.Signal=USART1_TX
PB7.GPIO_Label=RXD2
PB7.Signal=USART1_RX
PB8.GPIO_Label=DIR2(out)
PB8.Signal=GPIO_Output
PB9.GPIO_Label=DIR3(out)
PB9.Signal=GPIO_Output
PC0.GPIO_Label=CUR2(ADC2)
PC0.Signal=ADCx_INP10
PC1.Signal=ETH_MDC
PC10.Signal=SDMMC1_D2
PC11.Signal=SDMMC1_D3
PC12.Signal=SDMMC1_CK
PC13.GPIO_Label=B1 [Blue PushButton]
PC13.Signal=GPIO_Input
PC3_C.GPIO_Label=CUR3(ADC3)
PC3_C.Signal=ADC3_INP1
PC4.Signal=ETH_RXD0
PC5.Signal=ETH_RXD1
PC6.GPIO_Label=TXD1
PC6.Signal=USART6_TX
PC7.GPIO_Label=RXD1
PC7.Signal=USART6_RX
PC8.Signal=SDMMC1_D0
PC9.Signal=SDMMC1_D1
PD10.GPIO_Label=USB_OTG_FS_PWR_EN
PD10.Signal=GPIO_Output
PD2.Signal=SDMMC1_CMD
PD8.GPIO_Label=STLINK_RX
PD8.Signal=USART3_TX
PD9.GPIO_Label=STLINK_TX
PD9.Signal=USART3_RX
PE0.GPIO_Label=FIX1(EXTI0)
PE0.Signal=GPXTI0
PE1.GPIO_Label=LD2 [Yellow Led]
PE1.Signal=GPIO_Output
PE10.GPIO_Label=FIX4(PE10)
PE10.Signal=GPXTI10
PE12.GPIO_Label=FIX5(EXTI12)
PE12.Signal=GPXTI12
PE6.GPIO_Label=FIX3(EXTI6)
PE6.Signal=GPXTI6
PE7.GPIO_Label=FIX6(EXTI7)
PE7.Signal=GPXTI7
PE8.GPIO_Label=FOX7(out)
PE8.Signal=GPIO_Output
PE9.GPIO_Label=FOX8(out)
PE9.Signal=GPIO_Output
PG11.Signal=ETH_TX_EN
PG13.Signal=ETH_TXD0
PG2.GPIO_Label=SD_DET2(EXTI2)
PG2.Signal=GPXTI2
PG3.GPIO_Label=SD_DET1(EXTI3)
PG3.Signal=GPXTI3
